ZhangHanDong/openwalkietalkie/docs/host-research/critic.md

# critic

COMPLETENESS CRITIQUE (checked 2026-09-18 on this Mac: macOS 27.0 build 26A428, deck paired as "Codex Micro" C2:2D:81:AB:88:81 with HFP/AVRCP/A2DP/HID/BLE). Input caveat: the task says five reports but only three reached me (openmicrokbd, agent-cli-hooks, desktop-apps — the last cut off mid-sentence at "ChatGPT desktop: OUT of v1 ... + c"). Nothing I received covers (a) the voice pipeline (STT/TTS engines, audio device routing, mixer, permissions) or (b) the open-API transport/protocol/auth design; if reports 4 and 5 exist they must be checked against the facts below.

A. CONTRADICTIONS / CONFLICTS BETWEEN REPORTS AND SPEC
1. API transport: openmicrokbd report recommends line-delimited JSON-RPC over a Unix socket (optionally WebSocket); agent-cli-hooks recommends Claude Code `type:"http"` hooks POSTing to "the daemon's localhost API". Claude HTTP hooks only support http(s) URLs with optional headers (cc_hooks.md:514-535) — so a loopback HTTP listener is mandatory regardless, and Codex/Gemini hooks are command/mcp_tool only (codex_hooks.md:193), so a hook-helper binary is ALSO mandatory. Resolution: two front doors (Unix socket for GUI/scripts/deck-mcp with peer-cred auth; loopback HTTP with a per-install bearer token for hooks and non-Rust clients), one internal event bus.
2. Non-exclusive HID open: openmicrokbd lists "can hidapi open the BLE collection while Codex desktop holds it" as open; it is already done in production (host/src/main.rs:144 `set_open_exclusive(false)`, host/README.md:84 "opens HID without seizing the device"). The exclusive-access note in openmicrokbd fw/README is USB-only. Resolved.
3. Spec "daemon does no summarization; roster titles are window titles verbatim" (spec.md:39) vs. CLI report (titles come from hooks: session_name/thread name/prompt, not window titles; window titles on macOS need Screen Recording/Accessibility TCC) vs. spec "Auto-announce one-liner 'Agent 3: tests passing, ready'" (spec.md:116) which requires summarizing. Design must pick a title source per agent kind and a summarization policy (heuristic first-sentence vs LLM call needing an API key). Unresolved decision.
4. Ready-card "suggested next steps the agent offered" (spec.md:52, agent-command-deck.md:90-93 sends the highlighted step as `answer`) has no source in any CLI (agent-cli-hooks §5). Either drop `type:r` choices in v1 or synthesize.
5. Card capacities vs sources: `card.text` ≤128 B, ≤4 choices ×32 B, single choice (deck-protocol.md:115) vs Claude AskUserQuestion 1-4 questions with `multiSelect` and free-length labels, Codex approvals with long command strings, Codex requestUserInput 1-3 questions with `isOther`. Truncation + multiSelect policy (PTT-only? first N?) is undefined anywhere.
6. Report-size wording: deck-protocol.md:11 "63-byte reports" vs openmicrokbd "64-byte reports" — consistent (64 incl. report id 6; host/README.md:89-90 "64 bytes… BLE transports the 63 bytes after report ID 6"). Not a bug, but the orchestrator should state hidapi buffers as 64 bytes with byte 0 = 6.
7. Terminal fallback matrix (tmux/iTerm2/Terminal.app) omits the only terminal installed here: Ghostty (/Applications/Ghostty.app; tmux absent). Filled below.

B. GAPS NOBODY COVERED — FILLED WITH SOURCED ANSWERS
8. Session/gating rules the daemon must implement (deck-protocol.md:70-104, agent-command-deck.md:83-96, 248-268): hello every 5 s with random 32-bit sid and `hm`; device `hello.sid != mine` → full sync (`agent`/`card`/`reply`/`ws`/`macro`/`usage`[/`faces`]) then `synced`; `boot:1` → push persisted `faces`+`set`, `boot:0` → adopt device `faces` and persist; 15 s without hello = host offline on device; on link drop release every synthesised key and cancel any PTT utterance; handle `up`; device sends nothing on ch5 before the first host line; `answer` only sent while host present and the daemon MUST `card clear` within 5 s or the deck shows "not delivered" and reverts — i.e. clear when the answer is DELIVERED to the agent (hook response returned / keystrokes sent / app-server response), not when the agent acts; `focus` must echo `channel.seq` as `ack`; `ptt ctx:name` must be answered with `name` (≤16 B — 5 CJK chars); `ptt ctx:codex` only stops TTS; `set` for speaker/mic/announce/chime is host-side and must be persisted (device persists nothing, agent-command-deck.md:277-282); pacing ≤1 report/8 ms, ≤~4 `agent` updates/s/agent, firmware queue of 64 shared by all channels (deck-protocol.md:39-43).
9. Consequence of #8 pacing: two independent HID writers (today's icon-sync LaunchAgent + a new deck daemon) cannot coordinate the 8 ms pace or the 64-entry queue → fold channel-3 icon sync into the daemon (one reader/writer per host), keep `flock` single-instance (host/src/main.rs:36-55).
10. Audio devices (verified with CoreAudio probe): the deck appears as TWO CoreAudio devices both named "Codex Micro": input uid `C2-2D-81-AB-88-81:input` 1ch 16 kHz (HFP) and output uid `C2-2D-81-AB-88-81:output` 2ch 44.1 kHz (A2DP), transport `blue`. Select by UID/BT address (name is ambiguous, and identical across units); never change the system default device. HFP mic use forces the SCO route and suspends A2DP (firmware handles BT_NOTIFY_A2DP_SUSPEND_IND, native/src/bluetooth.c:452; Apple support: "quit any apps that use your Bluetooth headphones' built-in microphone" to restore quality). So: open the mic only for the PTT hold; TTS/chimes played during/just after PTT go through 8/16 kHz SCO; route flips add latency; the "audio mixer with priority queue" (spec.md:117) must survive device sample-rate/route changes.
11. STT on this Mac (ran the researcher's speechcheck): SFSpeechRecognizer en-US available+on-device; zh-CN and en-GB available but on-device=false (server-based, audio leaves the Mac); auth status 0 (notDetermined); macOS 26+ SpeechTranscriber: 45 supported locales, installed = 9 English locales only. Chinese PTT therefore needs Apple server recognition or a bundled local model (whisper.cpp/sherpa-onnx). No STT language setting exists in the Settings face (agent-command-deck.md:143-154) → daemon config must carry locale(s).
12. TTS: `say -v '?'` lists 186 voices here (64 en_/zh_); a 16 kHz mono test file exists in the scratchpad (tts_test16k.wav, 2.7 s) showing `say -o` output was tried. Per-agent voice identity (spec.md:135) is feasible with AVSpeechSynthesizer/`say -v`; unresolved: engine choice, voice→agent assignment persistence, stripping code fences/markdown before speaking `last_assistant_message`.
13. TCC for a headless daemon: TCC attributes a launchd agent to its own executable; microphone (and speech-recognition) prompts need an embedded `__info_plist` with CFBundleIdentifier, CFBundleName, NSMicrophoneUsageDescription (naudio issue #105; Apple forums 111100). Cleanest: ship the daemon inside the .app bundle and register it with SMAppService (macOS 13+, plist in `Contents/Library/LaunchAgents/`, `BundleProgram` relative path, `SMAppService.agent(plistName:)` register/unregister/status; user sees it in Login Items) — this also answers openmicrokbd's "where does the daemon live / Sparkle restarts" question. AX/keystroke/Automation grants must be requested by the daemon, not by the MCP child (desktop-apps).
14. Focus/injection on the installed terminal: Ghostty ≥1.3 AppleScript exposes application/window/tab/terminal/surface configuration; window `id,name,selected tab`; tab `id,name,index,selected,focused terminal`; terminal `id,name,working directory`; commands `focus`, `activate window`, `select tab`, `input text`, `send key`, `new window/tab`, `split`, `perform action`; needs Automation TCC. No tty/pid property and no per-surface env var (only GHOSTTY_RESOURCES_DIR, TERM_PROGRAM=ghostty) → map hook session→terminal by `working directory` == hook `cwd` (ambiguous if several sessions share a cwd) or by title; Claude's `terminalSequence` hook output can stamp a deterministic title (session id) to match Ghostty `name`.
15. Two-way focus sync on macOS: NSWorkspace gives app activation only; tab-level focus needs polling Ghostty `selected tab`/`focused terminal` (Automation) or AX focused-window title (Accessibility). Spec's channel 1-4 ↔ Ctrl+Alt+Shift+1..4 binds and `ws`/`key` Omarchy semantics have no macOS equivalent (no public Spaces API; window names need Screen Recording) → v1 macOS: Omarchy face pushes nothing or a degraded app list; decide.
16. Usage face sources: Claude Code statusLine JSON `rate_limits.five_hour/seven_day{used_percentage,resets_at}` (+`spend_limit`; Pro/Max only, only after first API response; cc_statusline.md:193-195, 293-300, 339); Codex app-server `account/rateLimits/read` → `{rateLimits{primary{usedPercent,windowDurationMins,resetsAt},secondary}, rateLimitsByLimitId, rateLimitResetCredits}` plus `account/rateLimits/updated` notification and `account/usage/read` (codex_appserver.txt:1424-1428, 1601-1625; requires an app-server connection); Gemini CLI: `/stats model` shows session usage and limits interactively, no programmatic daily-quota API; geminicli.com quota page states "Gemini CLI was replaced by Antigravity CLI on June 18th, 2026" for unpaid/Google One users. `refresh {what:usage}` from the deck → daemon re-queries.
17. Agent liveness: no SessionEnd fires on SIGKILL/closed terminal; capture the agent pid at SessionStart (`$PPID` of the hook shell → CLI process) and poll `kill(pid,0)`; Claude also offers `claude agents --json` (CLI report).
18. Third-party clients ("scripts, other tools"): the API needs a generic virtual-agent surface (register agent → slot id, push state/card/reply, receive answer/ptt/snooze) with a lease/heartbeat so a dead client's agents go `gone`, a slot policy for >8 sessions (device ids 1..8; LRU-evict Idle), and per-client scopes (hook payloads carry prompts/tool inputs; broadcasting them to every client is a privacy leak). Loopback HTTP must also defend against browser CSRF (token + Host/Origin check).
19. Linux/Omarchy (the spec's first-party target, spec.md:10,129-133) is untouched by all reports: Hyprland IPC socket `$XDG_RUNTIME_DIR/hypr/[HIS]/.socket.sock` (requests) and `.socket2.sock` (events), `hyprctl clients -j`/`activewindow -j`, `dispatch focuswindow address:0x…`; hidraw permissions (udev), BlueZ/PipeWire HFP (mSBC) — all unverified beyond the socket-1 path.

C. STILL UNKNOWN — see open_questions (SCO bring-up latency and lost first syllables, whether hidapi input reports are duplicated to every non-seizing client, HTTP-hook hold-open behaviour, summarization policy, multiSelect mapping, Codex acceptForSession via hooks, voice-command grammar for "report", Gemini future).

## Facts
- [verified] Only three researcher reports (openmicrokbd, agent-cli-hooks, desktop-apps) were delivered to this critic; the desktop-apps text is truncated mid-sentence and no report on the voice pipeline or on the open-API transport/auth design was received.
  - source: Task input as received by this subagent (2026-09-18)
- [verified] Claude Code HTTP hooks POST JSON to an http(s) `url` with optional `headers` whose `$VAR` values are interpolated only for variables listed in `httpHookAllowedEnvVars`; `allowedHttpHookUrls` restricts which URLs may run. Example in docs: `http://localhost:8080/hooks/pre-tool-use` with `Authorization: Bearer $MY_TOKEN`. There is no Unix-socket hook transport.
  - source: scratchpad/cc_hooks.md:282-283, 514, 531-535 (https://code.claude.com/docs/en/hooks, fetched 2026-09-18)
- [verified] Codex hooks support only `command` (with optional `async: true`) and `mcp_tool` handler types; `prompt`/`agent`/http are not supported, so Codex (and Gemini) integration needs a hook-helper executable on a stable path.
  - source: scratchpad/codex_hooks.md:191-193, 249-265, 564-600 (https://learn.chatgpt.com/docs/hooks)
- [verified] The existing host opens the BLE HID vendor collection non-exclusively (`api.set_open_exclusive(false)`) and coexists with the Codex desktop app on the same device; README states it 'opens HID without seizing the device' and that the full report is 64 bytes `[6, 3, len, payload…]` with BLE carrying the 63 bytes after report id 6.
  - source: /Users/tony/projects/conol/openmicrodial/host/src/main.rs:142-144; host/README.md:81-90
- [verified] Deck session rules a daemon must implement: hello every 5 s with a random 32-bit sid; device reply `sid` != mine → full sync then `synced`; `boot:1` → push persisted faces/set, `boot:0` → adopt device faces; 15 s without hello → device shows host offline; on link drop release synthesised keys and cancel PTT; `up` means everything released; device sends nothing on channel 5 before the first host line; host lines never echo as mirror events.
  - source: /Users/tony/projects/conol/openmicrodial/docs/deck-protocol.md:70-104
- [verified] `answer` is only sent while a host is present and the card shows 'sent' until the host sends `card clear`; with no clear within 5 s the card reverts and a 'not delivered' toast appears — so the daemon must acknowledge delivery within 5 s, independent of when the agent acts on it.
  - source: /Users/tony/projects/conol/openmicrodial/docs/deck-protocol.md:135; docs/agent-command-deck.md:83-85
- [verified] Pacing: at most one output report per 8 ms; the native firmware queues 64 messages shared by reports, input and diagnostics and drops the link on overflow; at most ~4 `agent` updates/s per agent; device per-edge events are ≥4 ms apart.
  - source: /Users/tony/projects/conol/openmicrodial/docs/deck-protocol.md:37-49
- [verified] The device persists nothing: strip (`faces`) and settings reset on every boot; speaker, mic gain, auto-announce and chime are host-side values the host must store and apply; brightness/idlehome/autojump/demo are device-side.
  - source: /Users/tony/projects/conol/openmicrodial/docs/agent-command-deck.md:143-158, 277-282
- [verified] `ptt ctx:name` requires the host to answer with `name {text ≤16 bytes}` while the naming overlay is open; `ptt ctx:codex` is used by the host only to stop speaking; `focus` must echo the device `channel.seq` as `ack` or it is applied unconditionally when `ack` is absent; `transcript` carries ≤200 B tail (send the last ~120 B) with `final:1` on the last one.
  - source: /Users/tony/projects/conol/openmicrodial/docs/deck-protocol.md:117-118, 123, 133-134; docs/agent-command-deck.md:175-178, 226-228
- [verified] The deck is paired with this Mac as 'Codex Micro' (address C2:2D:81:AB:88:81, VID 0x303A PID 0x8360, minor type Headset) with services HFP, AVRCP, A2DP, HID, BLE.
  - source: `system_profiler SPBluetoothDataType` run 2026-09-18 on this Mac
- [verified] CoreAudio exposes the deck as two devices both named 'Codex Micro': input uid `C2-2D-81-AB-88-81:input` (1 ch, 16000 Hz, transport blue) and output uid `C2-2D-81-AB-88-81:output` (2 ch, 44100 Hz). Device selection must use the UID/BT address, not the name.
  - source: scratchpad/list_audio (CoreAudio kAudioHardwarePropertyDevices probe compiled from list_audio.c) run 2026-09-18
- [verified] The firmware advertises HFP (0x111e), Audio Sink (0x110b), A/V Remote Control (0x110c/0x110e) and Generic Audio (0x1203) in its Classic EIR under the name 'Codex Micro', logs SCO codec/air-mode on connect (16 kHz for mSBC, 8 kHz CVSD, 32 kHz for codec id 3) and receives A2DP suspend/start indications.
  - source: /Users/tony/projects/conol/openmicrodial/native/src/bluetooth.c:17, 400-413, 425-437, 447-452
- [likely] On macOS, using a Bluetooth headset's microphone switches the device to the HFP/SCO route and degrades output quality; Apple's own guidance is to quit apps using the headset microphone to restore A2DP quality. Consequently TTS/chimes while the mic stream is open are 8/16 kHz mono and route switches add latency.
  - source: Web search 2026-09-18: https://discussions.apple.com/thread/256182176 ; https://support.coscreen.co/hc/en-us/articles/1500002060342 ; https://gist.github.com/dvf/3771e58085568559c429d05ccc339219 (secondary sources quoting Apple support text)
- [verified] On this Mac SFSpeechRecognizer reports en-US available with on-device recognition; zh-CN and en-GB available but on-device=false (server-based); authorization status notDetermined; macOS 26 SpeechTranscriber supports 45 locales with only 9 English locales installed (en_AU, en_GB, en_CA, en_SG, en_IE, en_IN, en_ZA, en_NZ, en_US).
  - source: scratchpad/speechcheck (Swift probe, source speechcheck.swift) run 2026-09-18
- [verified] `say -v '?'` lists 186 voices on this Mac, 64 of them en_* or zh_*; a 16 kHz mono 2.7 s TTS test file (tts_test16k.wav) exists in the scratchpad from prior experimentation.
  - source: `say -v '?' | wc -l`; `afinfo scratchpad/tts_test16k.wav` (2026-09-18)
- [likely] TCC attributes a launchd agent to its own executable; for microphone access a bare daemon needs an embedded `__info_plist` (CFBundleIdentifier, CFBundleName, NSMicrophoneUsageDescription) or the prompt/attribution misbehaves (naudio issue: denied permission captured silence with no diagnostic and the Privacy pane listed the raw binary name).
  - source: https://github.com/KJ5HST-LABS/naudio/issues/105 ; https://developer.apple.com/forums/thread/111100 ; https://developer.apple.com/documentation/bundleresources/information-property-list/nsmicrophoneusagedescription (search 2026-09-18)
- [likely] SMAppService (macOS 13+) registers a LaunchAgent whose plist lives in `<App>.app/Contents/Library/LaunchAgents/` with a `BundleProgram` path relative to the bundle, via `SMAppService.agent(plistName:)` `.register()/.unregister()/.status`; the whole bundle is code-signed together and the agent appears under System Settings Login Items.
  - source: https://developer.apple.com/forums/thread/745009?page=2 ; https://gist.github.com/Matejkob/f8b1f6a7606f30777552372bab36c338 ; https://theevilbit.github.io/posts/smappservice/ (Apple's own page returned no body to the fetcher)
- [verified] Ghostty is the only terminal emulator installed on this Mac (/Applications/Ghostty.app); tmux is not installed.
  - source: `ls /Applications | grep -i 'iterm\|ghostty\|warp\|kitty\|wezterm\|alacritty'`; `which tmux` (2026-09-18)
- [verified] Ghostty AppleScript (since Ghostty 1.3.0, Automation TCC) exposes classes application/window/tab/terminal/surface configuration with window `id,name,selected tab`, tab `id,name,index,selected,focused terminal`, terminal `id,name,working directory`, and commands `focus`, `activate window`, `select tab`, `input text`, `send key`, `send mouse *`, `new window/tab`, `split`, `perform action`, `close*`. No tty or pid property.
  - source: https://ghostty.org/docs/features/applescript (fetched 2026-09-18)
- [likely] Ghostty sets GHOSTTY_RESOURCES_DIR and TERM_PROGRAM=ghostty (TERM=xterm-ghostty) in child shells; there is no documented per-surface identifier env var, so a hook cannot learn its Ghostty surface id from the environment.
  - source: https://ghostty.org/docs/features/shell-integration ; https://ghostty.org/docs/config/reference (search 2026-09-18)
- [verified] Claude Code statusLine JSON includes `rate_limits.five_hour/seven_day/spend_limit{used_percentage, resets_at}`; present only for claude.ai Pro/Max (or apps-gateway spend limits), only after the first API response, each window independently absent.
  - source: scratchpad/cc_statusline.md:193-195, 293-305, 339 (https://code.claude.com/docs/en/statusline)
- [verified] Codex app-server exposes `account/rateLimits/read` → `{rateLimits{limitId, primary{usedPercent, windowDurationMins, resetsAt}, secondary, rateLimitReachedType}, rateLimitsByLimitId, rateLimitResetCredits}`, a server notification `account/rateLimits/updated`, and `account/usage/read` for token-activity summaries.
  - source: scratchpad/codex_appserver.txt:1409-1428, 1601-1625 (https://learn.chatgpt.com/docs/app-server)
- [verified] Gemini CLI shows session token usage and quota limits only interactively via `/stats model`; its quota page lists per-auth daily request limits (Google Account 1,000/1,500/2,000; API key free 250) and states 'Gemini CLI was replaced by Antigravity CLI on June 18th, 2026' for unpaid tier and Google One users; no programmatic remaining-quota API is documented.
  - source: https://geminicli.com/docs/resources/quota-and-pricing/ (fetched 2026-09-18); https://github.com/google-gemini/gemini-cli/discussions/3096
- [verified] The deck wire vocabulary `AgentKind` is exactly Claude/Codex/Gemini/Other and the Usage face takes ≤6 items {n(20), p 0..100, r(24), c?} with a `period` (12) string; `refresh {what:'usage'}` asks the host for a fresh `usage`.
  - source: /Users/tony/projects/conol/openmicrodial/src/deck/msg.rs:11-16; docs/deck-protocol.md:121, 139
- [verified] tools/deck-sim.py opens the device with python-hidapi `hid.device().open(vid,pid)`, sets non-blocking reads of 64 bytes, and sleeps `--pace` ms after every written report; it is the only reference host and no deck daemon exists yet.
  - source: /Users/tony/projects/conol/openmicrodial/tools/deck-sim.py:118-150; docs/agent-command-deck.md:275-276
- [likely] The spec's first-party integration target is Omarchy Linux/Hyprland (roster from hyprctl window titles, daemon shipped as an Omarchy module); none of the received reports covers the Linux side. Hyprland's request socket is `$XDG_RUNTIME_DIR/hypr/[HIS]/.socket.sock` with a second socket for event streaming; `hyprctl clients -j` / `activewindow -j` and `dispatch focuswindow address:…` are the relevant commands and `.socket2.sock` emits activewindow/windowtitle/openwindow/closewindow/workspace events.
  - source: scratchpad/spec.md:10, 29, 129-133; https://wiki.hypr.land/IPC/ (fetched 2026-09-18; only the socket-1 path was legible in the fetch, the rest is from prior knowledge)
- [verified] The spec demands features that no CLI exposes: 'suggested next steps' on Ready cards, a 'report' voice check-in producing a TTS status summary, and auto-announce one-liners — all require host-side summarization or an intent grammar, contradicting spec.md:39 'the daemon does no summarization'.
  - source: scratchpad/spec.md:39, 52, 112, 116; agent-cli-hooks report §5 ('suggested next steps have NO source in any CLI')
- [verified] The deck's `card` supports one selected choice among ≤4 strings of ≤32 bytes and text ≤128 bytes, whereas Claude AskUserQuestion allows `multiSelect` and 1-4 questions per call and Codex requestUserInput allows `isOther` free-form; no report defines the truncation/multiSelect mapping.
  - source: /Users/tony/projects/conol/openmicrodial/docs/deck-protocol.md:115; agent-cli-hooks facts on AskUserQuestion and item/tool/requestUserInput
- [verified] The machine reports macOS ProductVersion 27.0 BuildVersion 26A428, matching the desktop-apps report's environment line.
  - source: `sw_vers` (2026-09-18)

## Options
### Two front doors for the open API: Unix socket (JSON-RPC, peer-cred auth) + loopback HTTP (bearer token) over one internal event bus
- pros: Satisfies Claude HTTP hooks (mandatory http URL), Codex/Gemini command hooks via a tiny helper, gpui GUI and scripts over the socket, deck-mcp stdio child over the socket; token in the hook URL/header lives in the user's 0600 settings files; Origin/Host checks block browser CSRF.
- cons: Two listeners to secure and version; the hook helper binary still needs a stable non-translocated path (openmicrokbd refuses AppTranslocation).
- recommendation: Adopt; resolves the transport contradiction between the openmicrokbd and agent-cli-hooks reports.
### Fold icon sync (channel 3) into the deck daemon; one HID reader/writer per host
- pros: Only one process can honour the 8 ms pace and the shared 64-entry firmware queue; removes the second LaunchAgent and lock file.
- cons: Daemon must carry the Codex config.toml watcher and OMD2 codec from host/src; migration/uninstall of the existing com.conol.openmicrodial.icon-sync agent needed.
- recommendation: Adopt.
### Daemon as a signed helper inside the .app bundle registered with SMAppService, carrying an Info.plist with microphone/speech-recognition usage strings
- pros: Stable TCC identity for mic, speech, Accessibility and Automation grants; survives Sparkle updates; user-visible in Login Items; answers the openmicrokbd open question on daemon placement.
- cons: macOS 13+ only; the LaunchAgent cannot own a tray icon (GUI process still needed for that); first-run permission prompts must be driven by the GUI calling the daemon.
- recommendation: Adopt for macOS; keep tools/install-host.sh only as a dev fallback.
### Audio policy: open the deck mic (HFP) only during the PTT hold; play chimes/TTS to the A2DP output selected by UID; software gain implements the Speaker/Mic settings
- pros: Restores A2DP quality between utterances, no system-volume side effects, deterministic mixer priorities (question > ready > chatter, PTT preempts).
- cons: SCO bring-up latency may clip the first syllables (unmeasured); TTS played within ~1 s after PTT release goes through SCO; A2DP start latency may clip the first chime.
- recommendation: Adopt provisionally; measure SCO/A2DP switch latency on hardware before freezing (open question).
### STT engine: Apple Speech (SFSpeechRecognizer/SpeechTranscriber) for English on-device, with an opt-in server mode for zh-CN, or a bundled local model (whisper.cpp / sherpa-onnx) for offline Chinese
- pros: Zero-dependency English on this Mac; Chinese works today via Apple's server recognizer.
- cons: zh-CN audio leaves the machine with Apple Speech; local models add binary size/CPU; the Settings face has no language row so locale must live in daemon config/GUI.
- recommendation: Decide after the (missing) voice report is reconciled with the verified availability facts.

## Open questions
- Reports 4 and 5 (voice pipeline; API/transport design) were not delivered to this critic — verify they exist and reconcile them with the audio/STT/TTS/TCC facts above.
- SCO bring-up latency on macOS with this deck: how many ms from opening the HFP input device to first usable samples, and are the first syllables of a PTT utterance lost? Alternative of keeping the mic stream open (permanent SCO) costs battery and TTS quality — needs hardware measurement.
- Does macOS IOKit HID deliver every input report to every non-seizing client (Codex desktop + daemon) on a BLE HID device, and does the daemon's read loop ever starve Codex desktop's channel-2 replies? (Works empirically for icon sync; not proven under load.)
- While a synchronous Claude PermissionRequest/PreToolUse HTTP hook is held open waiting for the deck (the 5 s `card clear` budget vs human response time), is the terminal dialog suppressed, and what hold timeout/fall-through should the daemon use so both the terminal and the deck can answer?
- Title source per agent kind for the 64-byte roster one-liner on macOS (hook-derived session_name/thread name/prompt vs window title needing Screen Recording/Accessibility) — the spec's 'verbatim window title, no summarization' cannot be met via hooks.
- Summarization policy for auto-announce one-liners, the 'report' check-in and Ready-card next steps: heuristic (first sentence, strip code fences) or an LLM call (which provider/key, cost, privacy)?
- Mapping of Claude `multiSelect` AskUserQuestion, >4 options, and Codex `isOther` free-form questions onto the single-choice ≤4×32 B card; truncation rules for long approval commands in ≤128 B text.
- Voice-command grammar: how does the daemon distinguish a dictated order from commands like 'report', 'approve', 'switch to 3' in a PTT transcript, and in which languages?
- Codex 'Allow always/for session' from the deck: PermissionRequest hooks only allow/deny; acceptForSession exists only on the app-server path — should the card offer it only when the session is app-server-attached?
- What does the macOS daemon do with the Omarchy face (`ws`, `key`, workspace binds 1-4) — hide the face, push a degraded app list, or map SCROLL/LEFT/RIGHT to Mission Control keystrokes (CGEvent needs Accessibility)?
- Two-way focus sync on macOS: poll Ghostty `selected tab`/`focused terminal` via AppleScript (Automation TCC, ~500 ms) or observe AX focused-window titles (Accessibility)? Mapping a hook session to a Ghostty terminal when several sessions share a working directory (use `terminalSequence` title stamping?).
- Audio fallback policy when only the BLE HID link is up and Classic audio is not connected: play chimes/TTS on the Mac's default output, or stay silent and show it in Settings › Host?
- Slot policy: >8 live sessions vs `agent.id` 1..8, persistence of slot↔session mapping across daemon restarts, and eviction order.
- API scopes/privacy: which clients may read hook payloads (prompts, tool inputs) and which may answer cards or inject text; is remote (non-loopback) access in scope for the open API?
- Gemini CLI viability: given the June 18 2026 replacement by Antigravity CLI for unpaid/Google One users, does the design still target Gemini CLI hooks or Antigravity?
- Linux/Omarchy port: hidraw/udev permissions for VID 303A PID 8360, BlueZ+PipeWire HFP (mSBC) capture, hyprctl event socket parsing — none researched; needed for the DHH/Omarchy deliverable in the spec.
- Log rotation and crash diagnostics for the LaunchAgent (current install-host.sh appends to one unbounded log file); where do daemon and GUI logs go and how does the GUI surface them?
