ZhangHanDong/openwalkietalkie/docs/section-12-coverage.md

# §12 failure-mode coverage audit (week 8)

Scope: every v1 row of `docs/host-service.md` §12, lines 1181–1215 — **35 rows**. No row is
marked v1.1/v2 in its entirety; row 1197 is split and only its v1 half (banner + `lsof` listener
+ change port → `integrations.repair`) is audited here.

Method: located candidate tests across `host/crates/*/tests/`, every `#[cfg(test)]` module under
`host/crates/*/src/**` (993 `#[test]`/`#[tokio::test]` functions) and `tools/host-test.sh`; read
every cited body; then mutated production code for 18 clauses and recorded red/green. Every
mutation was reverted; `git status` is clean.

Read-only pass. Nothing in the repo was changed.

---

## Row-by-row

| # | Row (§12) | Verdict | Test(s) | Missing piece |
|---|---|---|---|---|
| 1181 | Daemon crash | **partial** | KeepAlive: `tools/host-test.sh:248` (packaging step) + `tools/assert-bundle-identity.sh:106`. New sid → resync: `host/crates/deckd/src/hid.rs:1229` `a_link_up_hellos_a_zero_sid_writes_the_barrier_and_synced_goes_live`, `host/crates/deckd/src/device/session.rs:206` `a_foreign_or_zero_sid_starts_a_sync_and_synced_returns_to_live`, `tools/host-test.sh:1487` (`--hardware` restart row). Orphan grace 300 s: `host/crates/deck-model/src/roster.rs:1164` `a_lease_expires_into_the_orphan_grace_and_then_removal`. Reseed: `host/crates/deckd/src/liveness.rs:739` `the_roster_corrects_state_and_name_and_leaves_everything_else_alone`, `:778` `seeding_is_opt_in_and_only_for_unknown_interactive_sessions` | No test kills a daemon and inspects recovery. "restart ≤10 s" unmeasured; "device shows `offline` only if the gap exceeds 15 s" has no test at all; "held hooks end with the HTTP connection" is only tested for an orderly `Shutdown` (`deck-model/src/store.rs:1698`), never for a crash |
| 1182 | Held hook's client goes away → `HoldGone` | **covered** (proved) | `host/crates/deckd/tests/hooks_door.rs:74` `a_hook_client_that_goes_away_releases_its_hold_at_once`; `host/crates/deckd/tests/holds_guard.rs:34` `hold_guard_drop_sends_hold_gone`; `host/crates/deckd/tests/adapters_claude.rs:548` `a_released_hold_degrades_to_focus_terminal_under_the_same_id`; `host/crates/deck-model/src/cards.rs:1723` `a_hold_is_written_then_cleared_and_hold_gone_degrades_at_once`; `host/crates/deckd/src/core/handle.rs:616` `a_dropped_reply_is_an_internal_error_and_the_hold_guard_reports_on_drop`; Retry refusal: `host/crates/deck-model/src/cards.rs:2155` `a_failed_hold_card_refuses_retry_and_a_timeout_card_can_be_released` | — (`hooks_door.rs:74` asserts `hold_s >= 60` up front so the pass cannot come from expiry: the best-designed test in the table) |
| 1183 | Core → hid channel overflow | **partial** (behaviour proved) | `host/crates/deckd/src/core/mod.rs:3309` `an_overflow_replays_the_removals_it_refused_before_re_projecting` (drives a real `hid::Link`, asserts replay order, the wire barrier and `status.overflows == 1`); `:3214` `delivery_effects_resolve_and_the_overflow_reprojects_the_store`; `host/crates/deck-model/src/store.rs:1307` `overflow_reprojects_and_asks_for_a_barrier` | (a) "when the channel **drains below half**" is not pinned — mutating the gate to `<= OPS_CAPACITY` leaves all 436 deckd lib tests green (see M2). (b) The row names `metrics.get.outbox_overflows`; **no such field exists** — `metrics.get` publishes `overflows` (`core/dispatch.rs:231`), and the only `metrics.get` assertion is the zero case (`core/dispatch.rs:1383`) |
| 1184 | Hid → core: slow core | **uncovered** | Only an incidental proxy: `host/crates/deckd/src/core/mod.rs:3048` `metrics_get_waits_for_a_fresh_report` happens to show a device line handled while the call is parked | Nothing asserts `run_core`'s `try_recv` drain runs **before** the `select!` (`core/mod.rs:2408`), nothing asserts the hid→core channel is unbounded/never blocks, and the "≥4 ms apart" wire limit has no test (the only 4 ms in the tree is the host→device pacer's input, which is clamped to an 8 ms floor) |
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
