ZhangHanDong/openwalkietalkie/docs/releases/0.10.0.zh-CN.md

# OpenWalkieTalkie 0.10.0 升级说明

0.10.0 在 deck 上新增电脑资源页面 **System**，显示 Mac 的 CPU、内存、GPU 和磁盘剩余空间。同时改善 Flappy Bird 的局部刷新，并延长三款游戏的合成背景音乐。

## 电脑资源页面

- **CPU**：所有核心合计后的归一化使用率，范围 0–100%。
- **Memory**：已用／总内存，包括应用、不可换出（wired）和压缩内存。
- **GPU**：读取显卡驱动提供的利用率；多 GPU 时显示最忙的一颗。
- **Storage**：启动磁盘可写数据卷的可用／总空间。百分比表示**剩余空间**，空间较少时会改变提示颜色。

Mac 服务每 **2 秒**采样，只重绘显示值发生变化的表条。不可用的指标显示 **Not available**；超过 10 秒没有新数据时显示 **STALE**，主机断开后显示 **OFFLINE**。CPU 百分比需要两次采样后才会出现。

该页面仅在 **deck** 上提供，与订阅额度的 Usage 页面分开。新默认布局中，System 位于 Usage 后方。已有布局保持原样，请在 deck 上**双击 Shift → + → System → Enter** 添加。

需要同时更新 Mac 应用／deckd 服务和设备固件。旧服务不会发送电脑资源数据，新服务也不会向不支持此功能的旧固件发送这些消息。
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
