ZhangHanDong/openwalkietalkie/docs/mockups/1-face-strip.png

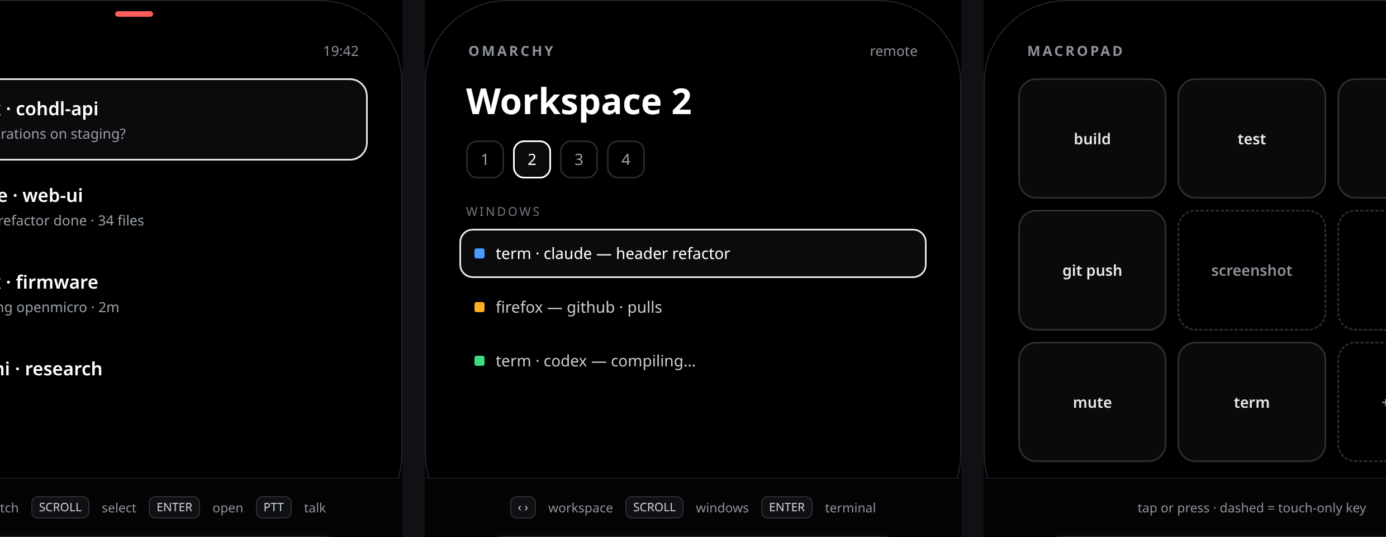
docs/mockups/1-face-strip.png
