ZhangHanDong/openwalkietalkie/docs/mockups/2-face-manager.png

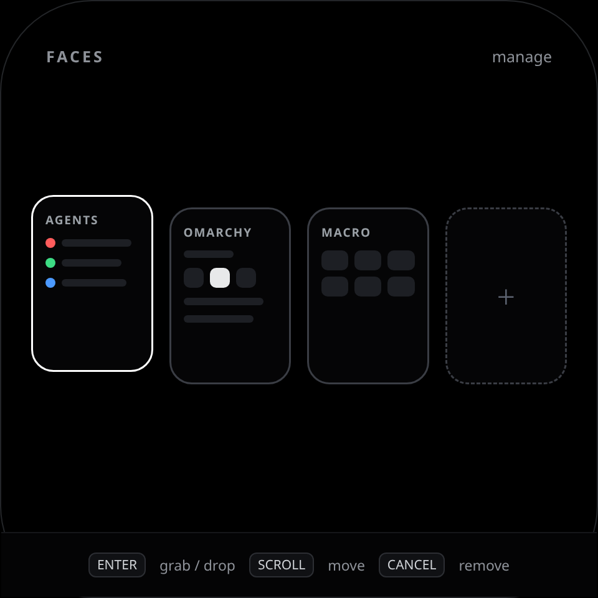
docs/mockups/2-face-manager.png
