ZhangHanDong/openwalkietalkie/docs/mockups/3-omarchy-remote.png

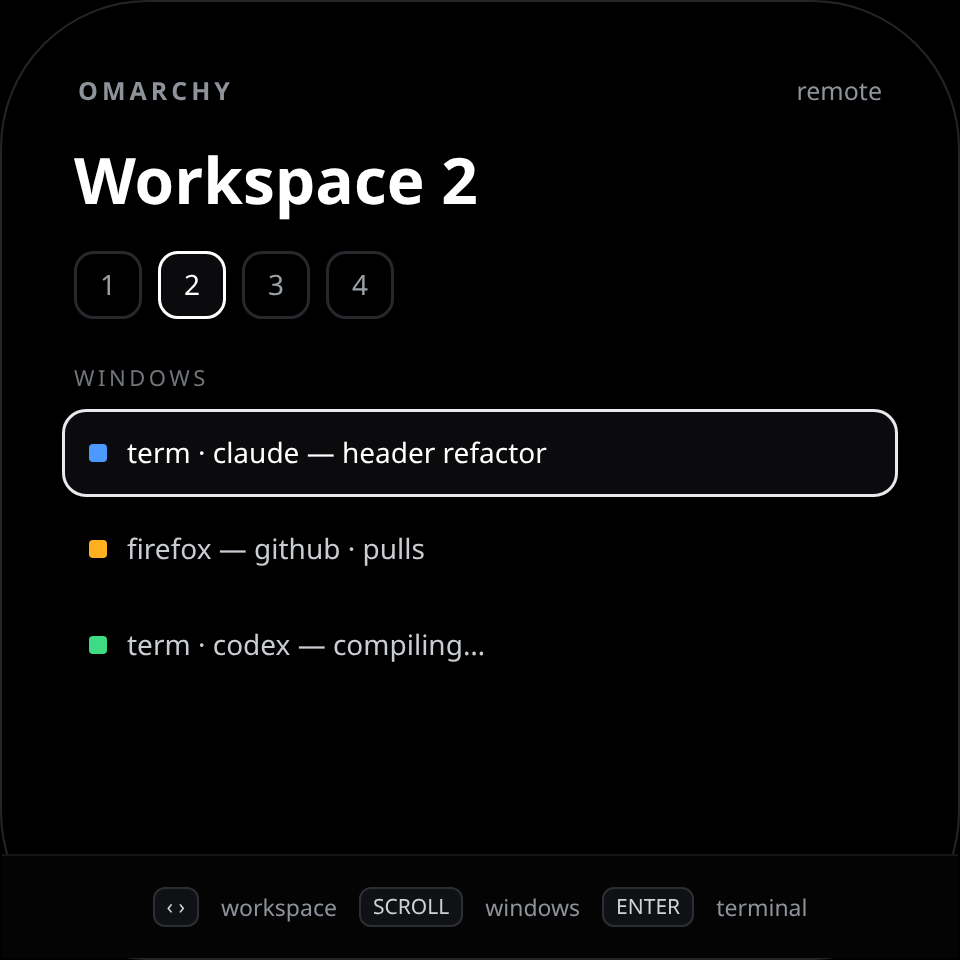
docs/mockups/3-omarchy-remote.png
