ZhangHanDong/openwalkietalkie/docs/mockups/4-macropad.png

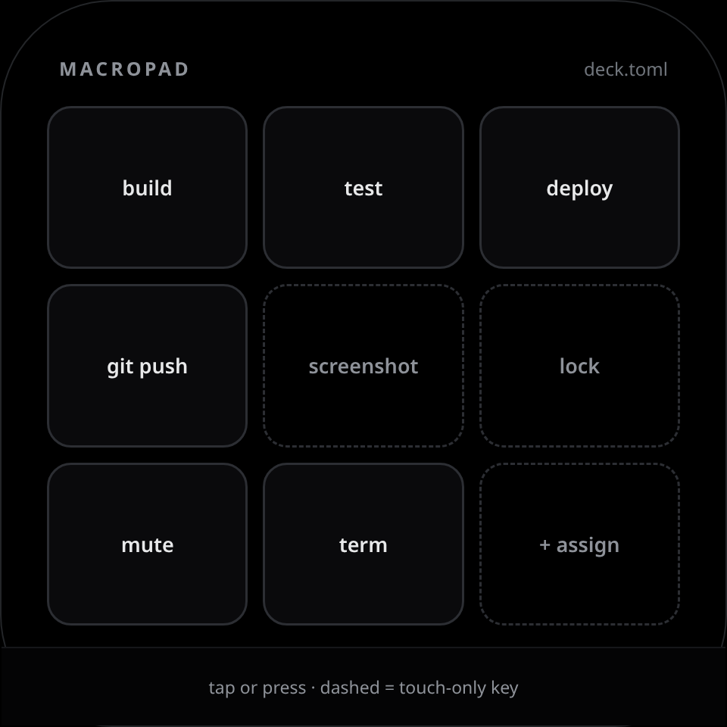
docs/mockups/4-macropad.png
