ZhangHanDong/openwalkietalkie/docs/mockups/6-roster.png

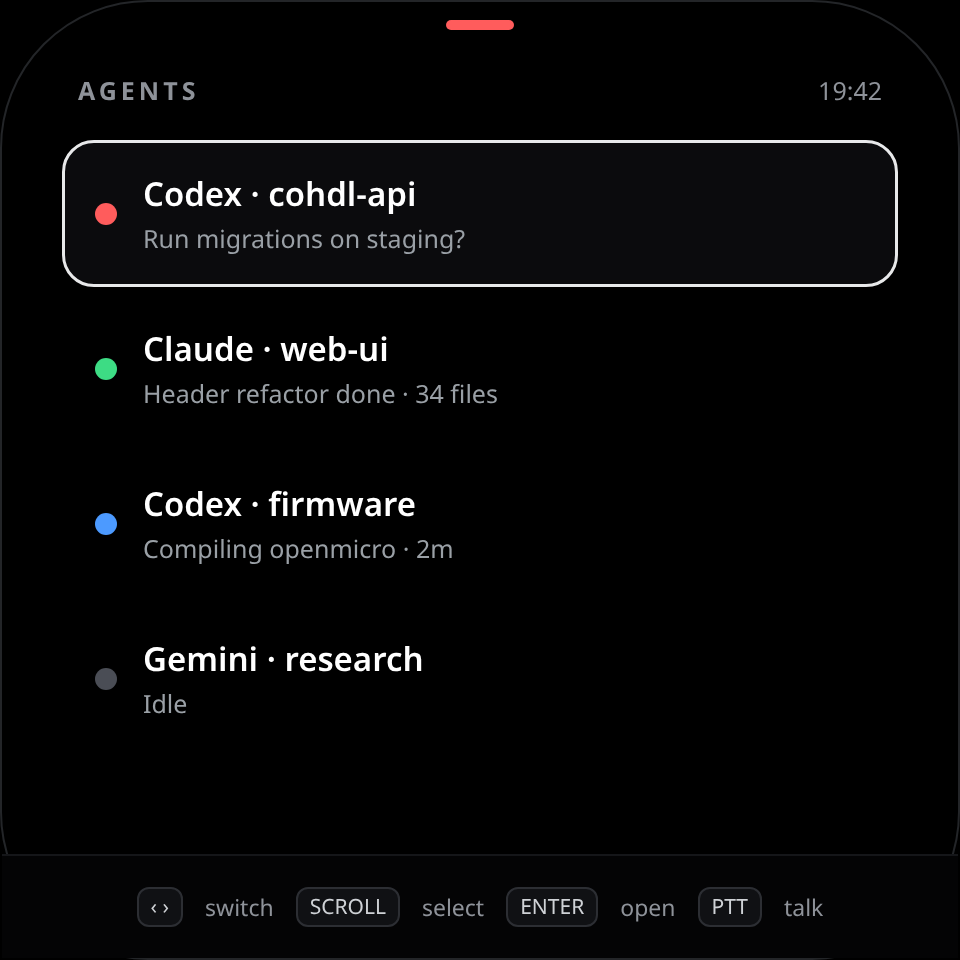
docs/mockups/6-roster.png
