ZhangHanDong/openwalkietalkie/docs/mockups/7-channel-ptt.png

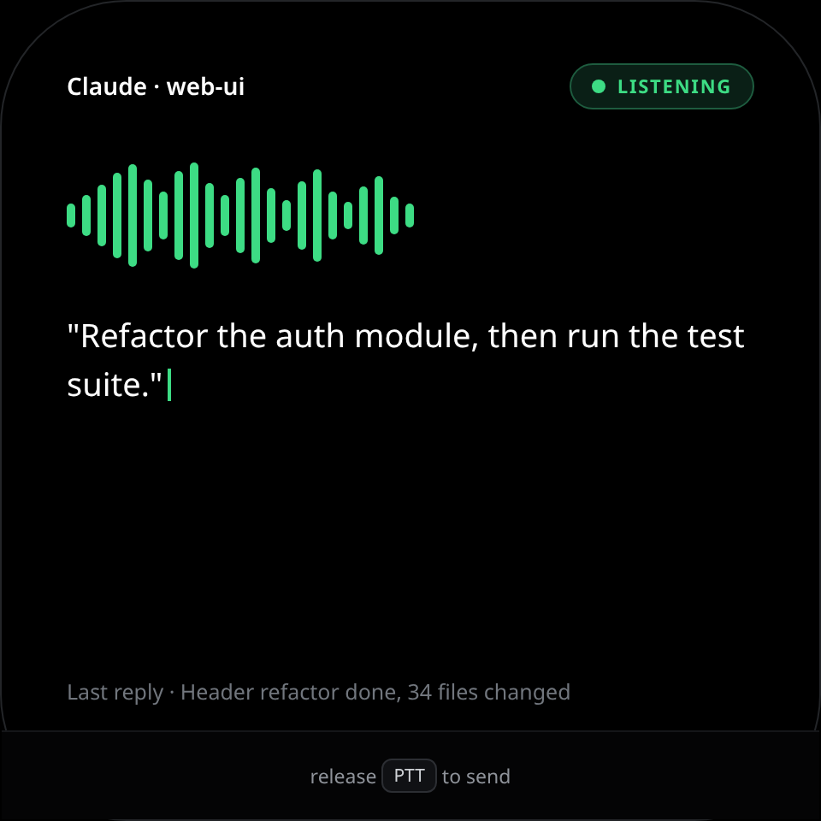
docs/mockups/7-channel-ptt.png
