ZhangHanDong/openwalkietalkie/docs/mockups/8-question-card.png

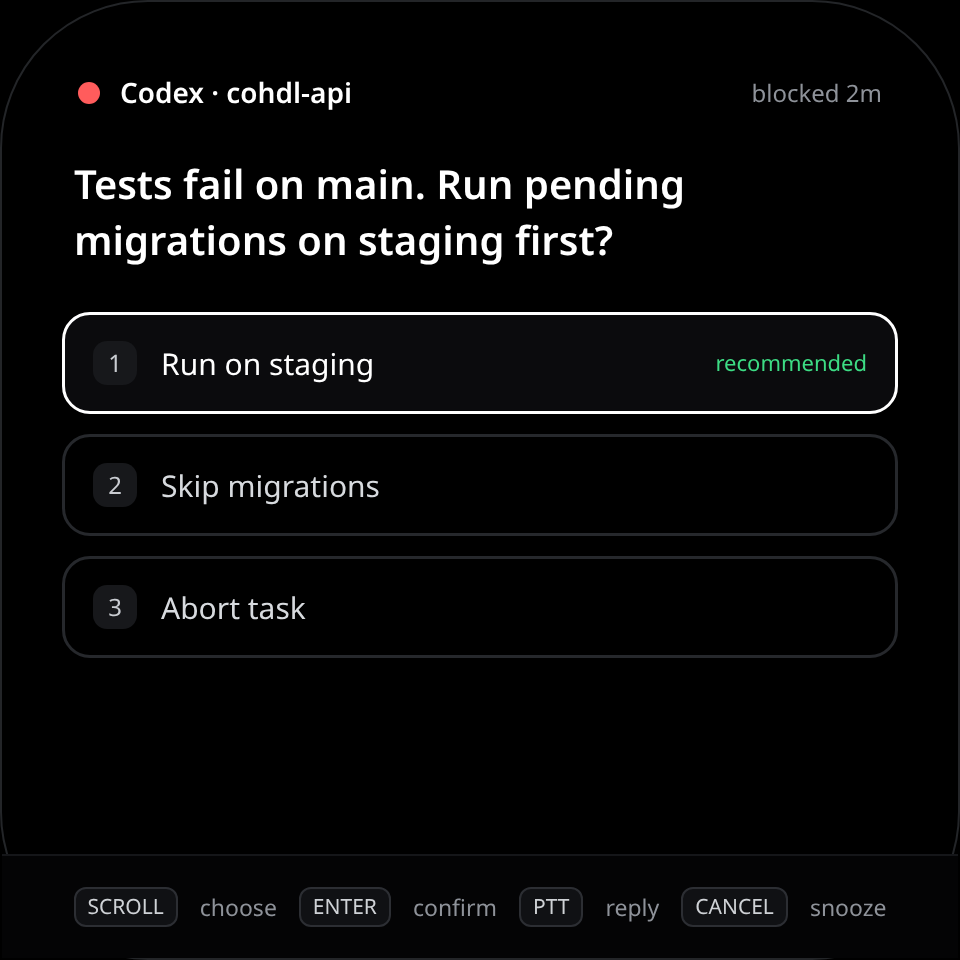
docs/mockups/8-question-card.png
