ZhangHanDong/openwalkietalkie/hardware/rev-b/jig/fab-jlcpcb/revb-flash-jig-bom-jlcpcb.csv

Comment | Designator | Footprint | LCSC Part # | Quantity | Design MPN | Design Manufacturer
UART | J1 | PinHeader_1x03_P2.54mm_Vertical | C49257 | 1 | 2.54-1*3PPin | BOOMELE
YZ105312061P-01 | P1,P2,P3 | Pogo_Xinyangze_YZ105312061P-01 | C5157237 | 3 | YZ105312061P-01 | Xinyangze
