ZhangHanDong/openwalkietalkie/hardware/rev-b/3d/bodyv6.13-revb-fit-assembly.step

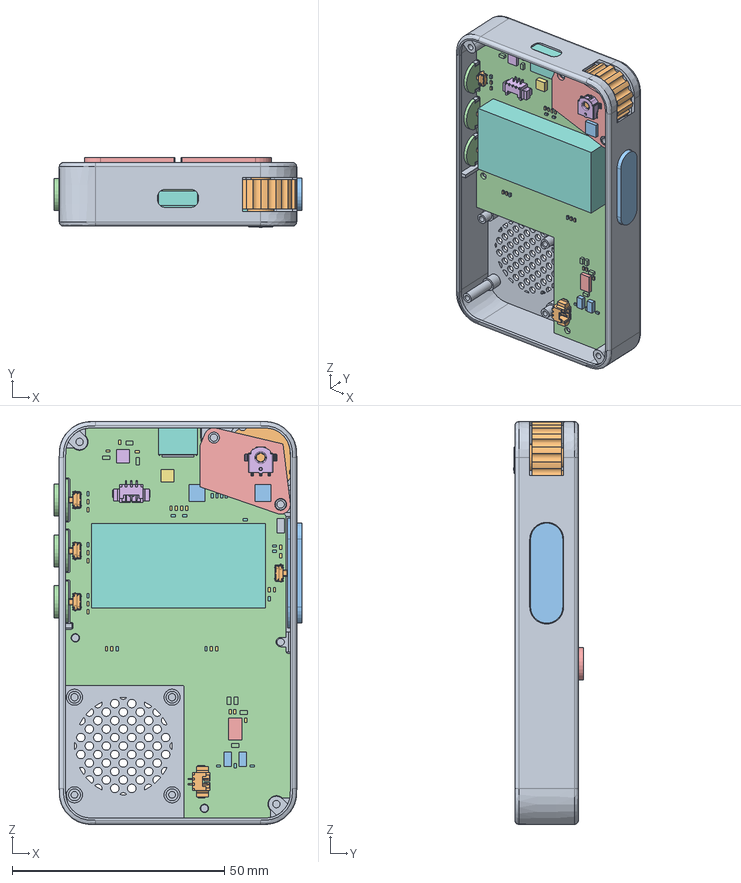
[picture p11: CAD file, 2026-10-13]
hardware/rev-b/3d/bodyv6.13-revb-fit-assembly.step
58.4 x 16.5 x 95.0 mm
