ZhangHanDong/openwalkietalkie/hardware/rev-b/3d/main-revb-populated-bodyv6.13.step

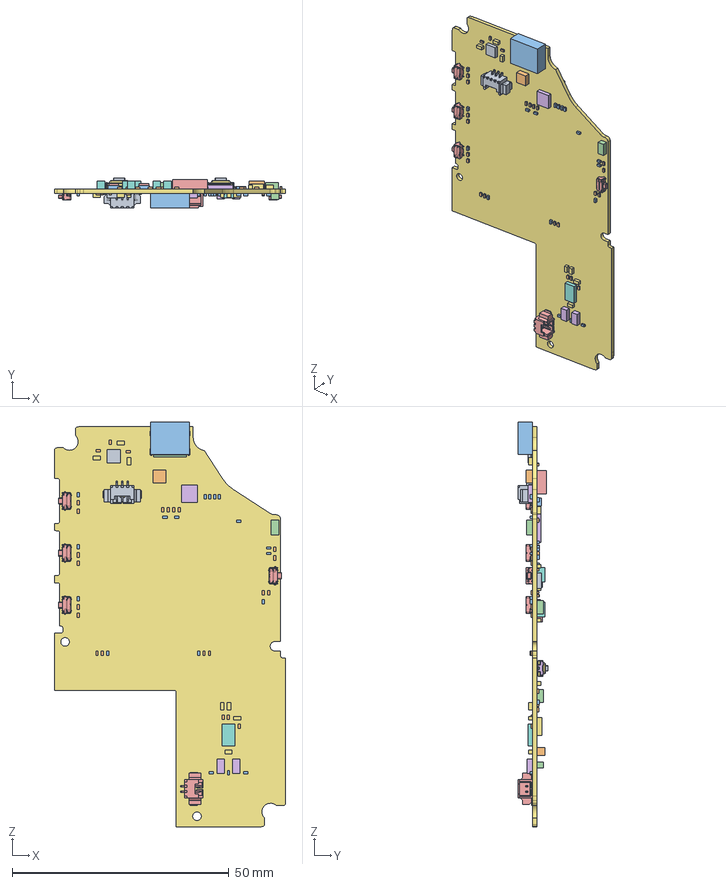
[picture p12: CAD file, 2026-10-13]
hardware/rev-b/3d/main-revb-populated-bodyv6.13.step
53.4 x 7.02 x 93.4 mm
