ZhangHanDong/openwalkietalkie/hardware/rev-b/models/RC0402FR-07604KL.step

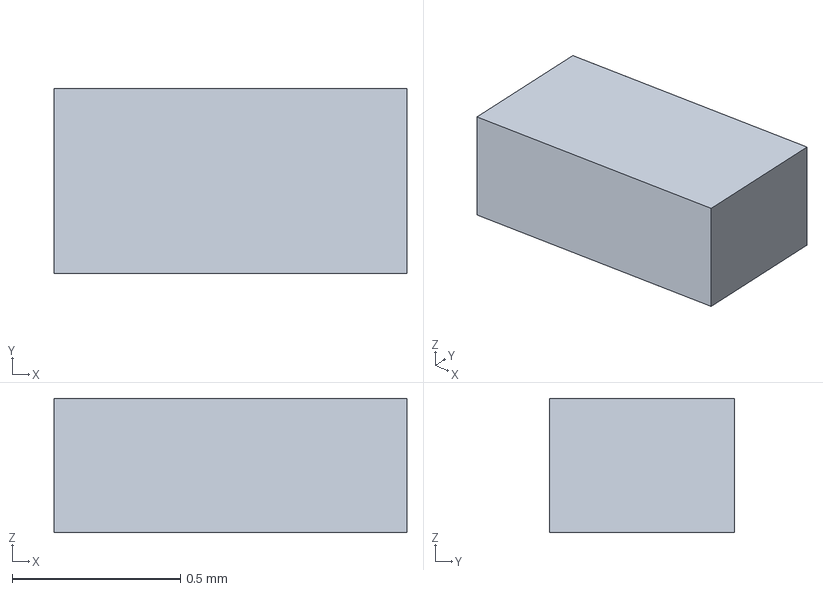
[picture p13: CAD file, 2026-10-13]
hardware/rev-b/models/RC0402FR-07604KL.step
1.05 x 0.55 x 0.4 mm
