ZhangHanDong/openwalkietalkie/hardware/rev-b/models/MP34DT05TR-A.step

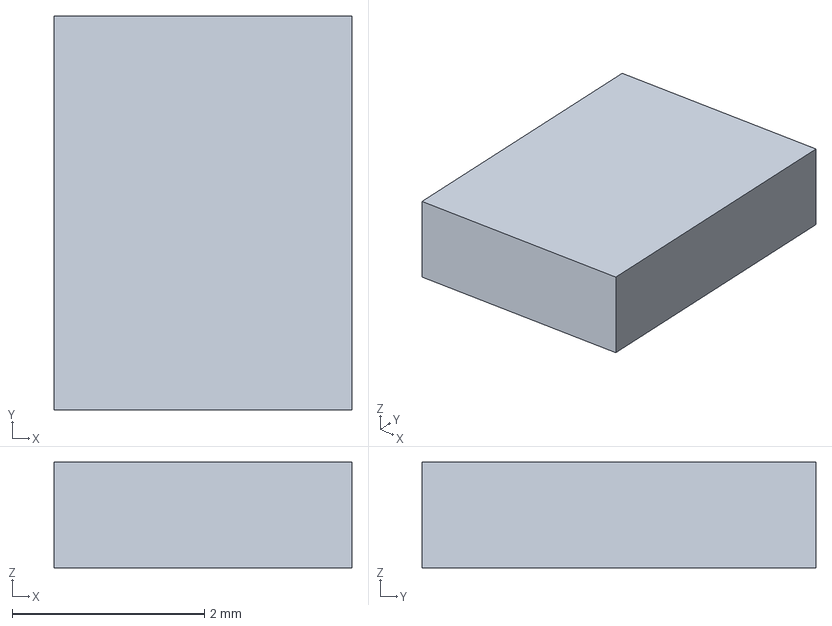
[picture p14: CAD file, 2026-10-13]
hardware/rev-b/models/MP34DT05TR-A.step
3.10 x 4.10 x 1.10 mm
