ZhangHanDong/openwalkietalkie/hardware/rev-b/models/DFE201612E-2R2M_P2.step

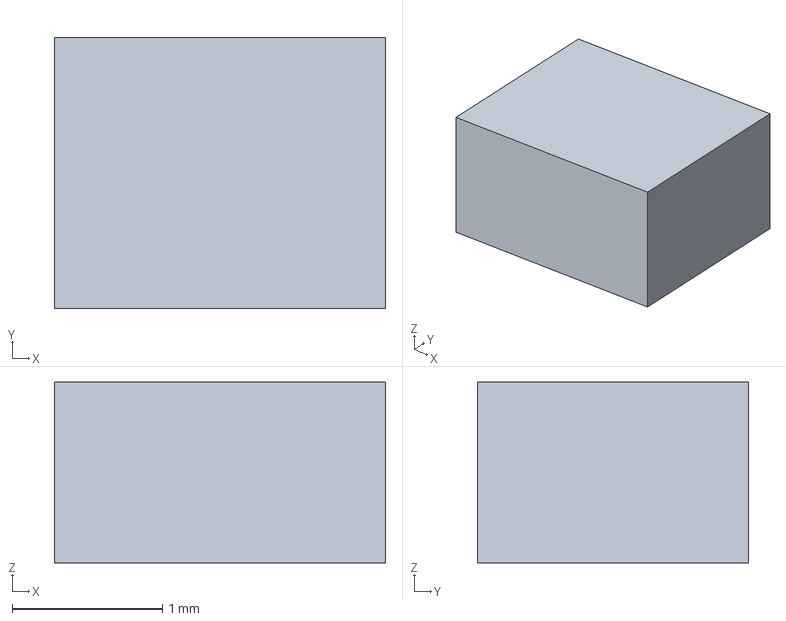
[picture p15: CAD file, 2026-10-13]
hardware/rev-b/models/DFE201612E-2R2M_P2.step
2.20 x 1.80 x 1.20 mm
