ZhangHanDong/openwalkietalkie/hardware/rev-a/pcb-release-bodyv5-20260917-r3/3d/main-populated-bodyv5.step

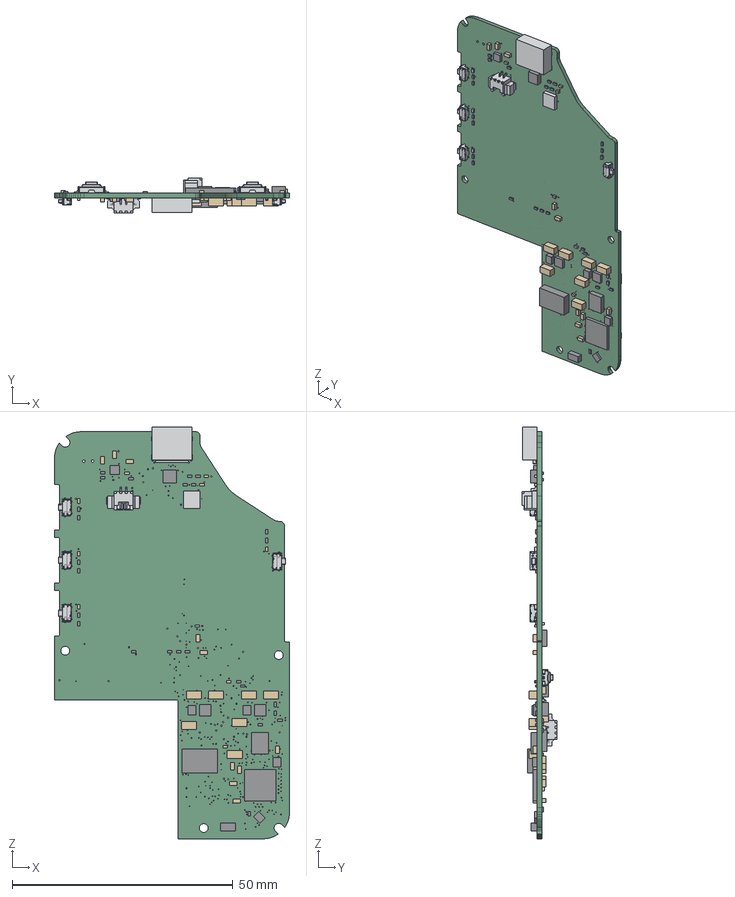
[picture p16: CAD file, 2026-10-13, an earlier design]
hardware/rev-a/pcb-release-bodyv5-20260917-r3/3d/main-populated-bodyv5.step
53.4 x 7.90 x 93.4 mm
PCB_finished_stackup_envelope
AE1
C1
C10
C11
C12
C13
C14
C15
C16
C17
C18
C19
C2
C20
C21
C22
C23
C24
C25
C26
C27
C28
C29
C3
C30
C31
C32
C33
C34
C35
C36
C37
C38
C39
C4
C40
C41
C42
C43
C44
C45
C46
C47
C48
C49
C5
C50
C51
C6
C7
C8
C9
J1
J2
J3
J5
L1
L2
L3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
