ZhangHanDong/openwalkietalkie/hardware/rev-a/pcb-release-bodyv6-20260922-r4/source/main/mechanical/main-mechanical.dxf

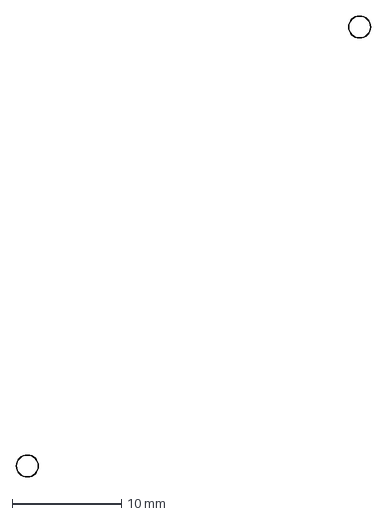
[picture p17: CAD file, 2026-10-13, an earlier design]
hardware/rev-a/pcb-release-bodyv6-20260922-r4/source/main/mechanical/main-mechanical.dxf
32.4 x 42.2 mm
