ZhangHanDong/openwalkietalkie/hardware/rev-a/pcb-release-bodyv6.13-20260923-r6/source/main/mechanical/main-outline.dxf

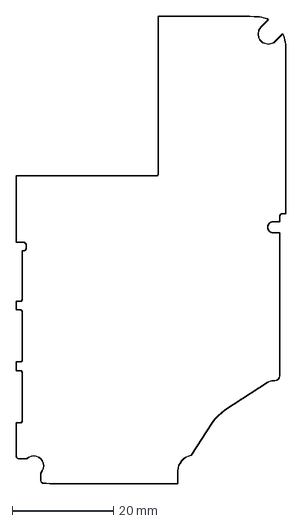
[picture p18: CAD file, 2026-10-13, an earlier design]
hardware/rev-a/pcb-release-bodyv6.13-20260923-r6/source/main/mechanical/main-outline.dxf
53.4 x 92.4 mm
