ZhangHanDong/openwalkietalkie/hardware/rev-a/pcb-release-bodyv5-20260917-r3/3d/bodyv5-fit-assembly.step

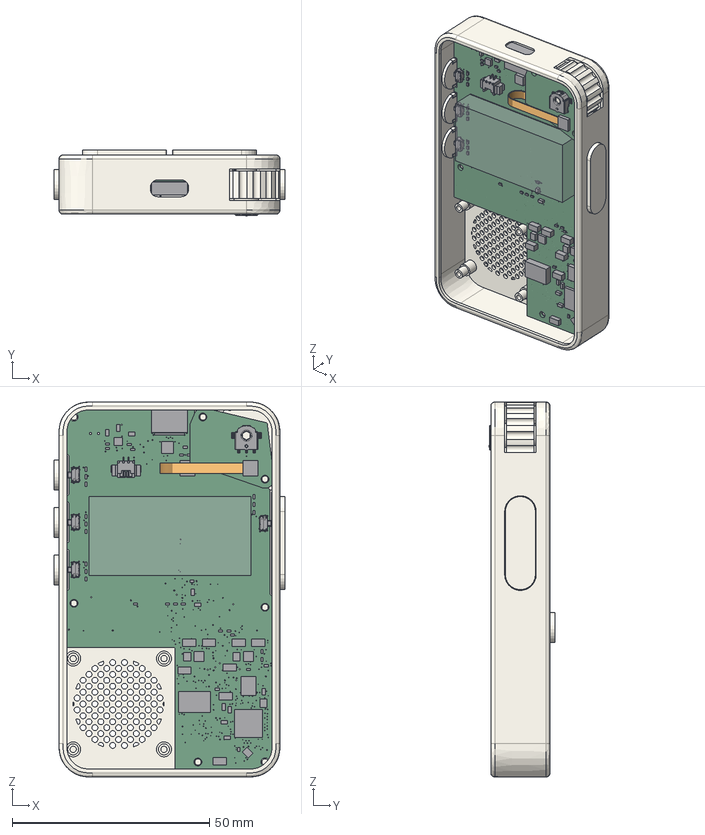
[picture p20: CAD file, 2026-10-13, an earlier design]
hardware/rev-a/pcb-release-bodyv5-20260917-r3/3d/bodyv5-fit-assembly.step
58.4 x 16.6 x 95.0 mm
MainCase
Wheel
PTT
Enter
Cancel
Shift
MacroLeft
MacroRight
main_PCB
encoder_PCB
main_AE1
main_C1
main_C10
main_C11
main_C12
main_C13
main_C14
main_C15
main_C16
main_C17
main_C18
main_C19
main_C2
main_C20
main_C21
main_C22
main_C23
main_C24
main_C25
main_C26
main_C27
main_C28
main_C29
main_C3
main_C30
main_C31
main_C32
main_C33
main_C34
main_C35
main_C36
main_C37
main_C38
main_C39
main_C4
main_C40
main_C41
main_C42
main_C43
main_C44
main_C45
main_C46
main_C47
main_C48
main_C49
main_C5
main_C50
main_C51
main_C6
main_C7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
