ZhangHanDong/openwalkietalkie/hardware/rev-a/pcb-release-bodyv5-20260917-r3/source/main/mechanical/main-mechanical.dxf

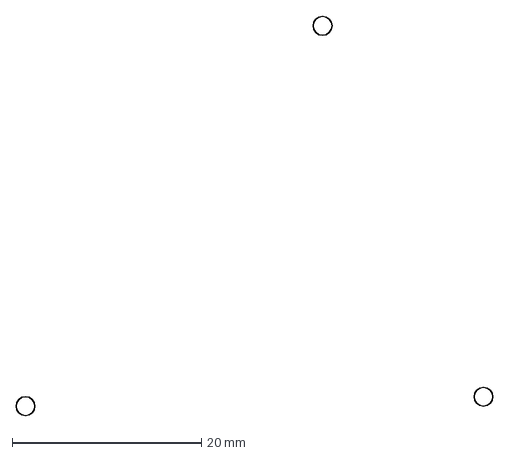
[picture p21: CAD file, 2026-10-13, an earlier design]
hardware/rev-a/pcb-release-bodyv5-20260917-r3/source/main/mechanical/main-mechanical.dxf
50.4 x 42.2 mm
