ZhangHanDong/openwalkietalkie/hardware/rev-a/pcb-release-bodyv6-20260922-r4/source/main/mechanical/main-outline.dxf

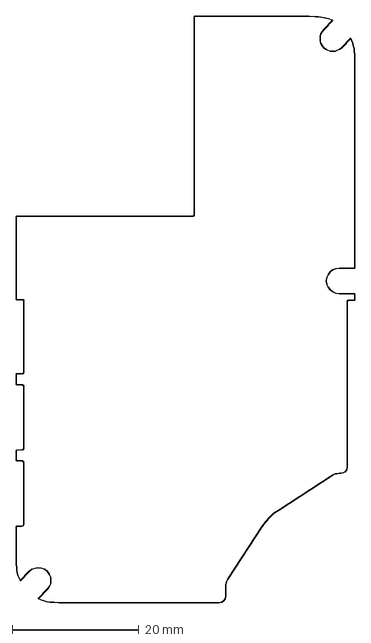
[picture p22: CAD file, 2026-10-13, an earlier design]
hardware/rev-a/pcb-release-bodyv6-20260922-r4/source/main/mechanical/main-outline.dxf
53.4 x 92.4 mm
