ZhangHanDong/openwalkietalkie/(list of files, cad)

Other CAD files:
hardware/rev-b/3d/main-revb-populated-native.step
hardware/rev-b/models/RC0402FR-075K1L.step
hardware/rev-a/pcb-release-bodyv5-20260917-r3/source/main/mechanical/main-outline.dxf
hardware/rev-a/pcb-release-bodyv6-20260922-r4/3d/main-populated-bodyv6.step
hardware/rev-a/pcb-release-bodyv6-20260922-r4/3d/main-populated-native.step
hardware/rev-a/pcb-release-bodyv6.9-20260922-r5/3d/main-populated-bodyv6.9.step
hardware/rev-a/mechanical-source/case/BodyV5-USB-face-battery-fit.f3d
hardware/rev-a/mechanical-source/case/BodyV5-USB-face-battery-fit.step
hardware/rev-a/mechanical-source/case/BodyV6.12.f3d
hardware/rev-a/mechanical-source/case/BodyV6.12.step
hardware/rev-a/mechanical-source/case/BodyV6.13.f3d
hardware/rev-a/mechanical-source/case/BodyV6.13.step
hardware/rev-a/mechanical-source/case/BodyV6.9.f3d
hardware/rev-a/mechanical-source/case/BodyV6.9.step
hardware/rev-a/mechanical-source/case/BodyV6.f3d
hardware/rev-a/mechanical-source/case/BodyV6.step
hardware/rev-a/mechanical-source/display/FPC3-H0175Y003MT006-1_V0.dxf
hardware/rev-a/mechanical-source/display/H0216F002AMT003A_V2.dxf
hardware/rev-a/pcb-release-bodyv5-20260917-r3/3d/encoder-populated-bodyv5.step
hardware/rev-a/pcb-release-bodyv5-20260917-r3/3d/encoder-populated-native.step
hardware/rev-a/pcb-release-bodyv5-20260917-r3/3d/interboard-cable-envelope-bodyv5.step
hardware/rev-a/pcb-release-bodyv5-20260917-r3/3d/main-populated-native.step
hardware/rev-a/pcb-release-bodyv5-20260917-r3/models/CC0603KRX5R6BB475.step
hardware/rev-a/pcb-release-bodyv5-20260917-r3/models/E1SB48E001G00E.step
hardware/rev-a/pcb-release-bodyv5-20260917-r3/models/FH34SRJ-4S-0.5SH_99_.step
hardware/rev-a/pcb-release-bodyv5-20260917-r3/models/RC0402FR-0722KL.step
hardware/rev-a/pcb-release-bodyv5-20260917-r3/models/RT6150BGQW.step
hardware/rev-a/pcb-release-bodyv5-20260917-r3/models/SPM1423HM4H-B.step
hardware/rev-a/pcb-release-bodyv5-20260917-r3/source/encoder/mechanical/encoder-mechanical.dxf
hardware/rev-a/pcb-release-bodyv6-20260922-r4/3d/bodyv6-fit-assembly.step
hardware/rev-a/pcb-release-bodyv6-20260922-r4/3d/encoder-populated-bodyv6.step
hardware/rev-a/pcb-release-bodyv6-20260922-r4/models/8.03A5.031250.step
hardware/rev-a/pcb-release-bodyv6-20260922-r4/models/C3216X7R1C106K160AC.step
hardware/rev-a/pcb-release-bodyv6-20260922-r4/models/CC0402JRNPO9BN102.step
hardware/rev-a/pcb-release-bodyv6-20260922-r4/models/CC0402KRX5R6BB474.step
hardware/rev-a/pcb-release-bodyv6-20260922-r4/models/CC0402KRX7R7BB104.step
hardware/rev-a/pcb-release-bodyv6-20260922-r4/models/PTS636SM25SMTRLFS.step
hardware/rev-a/pcb-release-bodyv6-20260922-r4/models/RC0402FR-071KL.step
hardware/rev-a/pcb-release-bodyv6-20260922-r4/models/RC0402FR-071ML.step
hardware/rev-a/pcb-release-bodyv6-20260922-r4/models/RC0402FR-0722RL.step
hardware/rev-a/pcb-release-bodyv6-20260922-r4/models/RC0402FR-0786K6L.step
hardware/rev-a/pcb-release-bodyv6-20260922-r4/models/SGM41562SAXTYH10G_TR.step
hardware/rev-a/pcb-release-bodyv6-20260922-r4/models/TYPE-C-31-M-12.step
hardware/rev-a/pcb-release-bodyv6-20260922-r4/models/_superseded-OK-F302-31115.step
hardware/rev-a/pcb-release-bodyv6.13-20260923-r6/3d/bodyv6.13-encoder-wheel-fit-assembly.step
hardware/rev-a/pcb-release-bodyv6.13-20260923-r6/3d/bodyv6.13-fit-assembly.step
hardware/rev-a/pcb-release-bodyv6.13-20260923-r6/3d/encoder-populated-bodyv6.13.step
hardware/rev-a/pcb-release-bodyv6.13-20260923-r6/3d/encoder-populated-native.step
hardware/rev-a/pcb-release-bodyv6.13-20260923-r6/3d/encoder-wheel-populated-bodyv6.13.step
hardware/rev-a/pcb-release-bodyv6.13-20260923-r6/3d/encoder-wheel-populated-native.step
hardware/rev-a/pcb-release-bodyv6.13-20260923-r6/3d/main-populated-bodyv6.13.step
hardware/rev-a/pcb-release-bodyv6.13-20260923-r6/3d/main-populated-native.step
hardware/rev-a/pcb-release-bodyv6.13-20260923-r6/encoder-wheel/mechanical/wheel-with-encoder-cavity-bodyv6.13.step
hardware/rev-a/pcb-release-bodyv6.13-20260923-r6/models/BQ24073RGTR.step
hardware/rev-a/pcb-release-bodyv6.13-20260923-r6/models/CC0603JRNPO9BN152.step
hardware/rev-a/pcb-release-bodyv6.13-20260923-r6/models/CC0603KRX5R6BB105.step
hardware/rev-a/pcb-release-bodyv6.13-20260923-r6/models/CC1206JRNPO8BN104.step
hardware/rev-a/pcb-release-bodyv6.13-20260923-r6/models/EC05E1220401.step
hardware/rev-a/pcb-release-bodyv6.13-20260923-r6/models/NS4150B.step
hardware/rev-a/pcb-release-bodyv6.13-20260923-r6/models/RC0402FR-07100KL.step
hardware/rev-a/pcb-release-bodyv6.13-20260923-r6/models/RC0402FR-0710KL.step
hardware/rev-a/pcb-release-bodyv6.13-20260923-r6/models/RC0402FR-072K55L.step
hardware/rev-a/pcb-release-bodyv6.13-20260923-r6/models/RC0402JR-070RL.step
hardware/rev-a/pcb-release-bodyv6.13-20260923-r6/models/SF32LB525UC6.step
hardware/rev-a/pcb-release-bodyv6.13-20260923-r6/models/USBLC6-2SC6.step
hardware/rev-a/pcb-release-bodyv6.9-20260922-r5/3d/bodyv6.9-fit-assembly.step
hardware/rev-a/pcb-release-bodyv6.9-20260922-r5/3d/encoder-populated-native.step
hardware/rev-a/pcb-release-bodyv6.9-20260922-r5/3d/main-populated-native.step
hardware/rev-a/pcb-release-bodyv6.9-20260922-r5/models/2450AT18B100E.step
hardware/rev-a/pcb-release-bodyv6.9-20260922-r5/models/BLM31PG601SN1L.step
hardware/rev-a/pcb-release-bodyv6.9-20260922-r5/models/CC0402JRNPO9BN331.step
hardware/rev-a/pcb-release-bodyv6.9-20260922-r5/models/CC0603KRX5R6BB225.step
hardware/rev-a/pcb-release-bodyv6.9-20260922-r5/models/CC0805KRX5R8BB106.step
hardware/rev-a/pcb-release-bodyv6.9-20260922-r5/models/RC0402FR-07442KL.step
hardware/rev-a/pcb-release-bodyv6.9-20260922-r5/models/RT6150B-33GQW.step
hardware/rev-a/pcb-release-bodyv6.9-20260922-r5/models/SKTDLDE010.step
hardware/rev-a/pcb-release-bodyv6.9-20260922-r5/models/TPS22918DBVR.step
hardware/rev-a/pcb-release-bodyv6.9-20260922-r5/models/W25Q128JVSIQ.step
hardware/rev-a/pcb-release-bodyv6.9-20260922-r5/models/WPN201610U4R7MT.step
hardware/rev-a/pcb-release-bodyv6.9-20260922-r5/source/encoder/mechanical/encoder-mechanical.dxf
hardware/rev-a/pcb-release-bodyv6.9-20260922-r5/source/encoder/mechanical/encoder-outline.dxf
