ZhangHanDong/openwalkietalkie/docs/mockups/5-usage-report.png

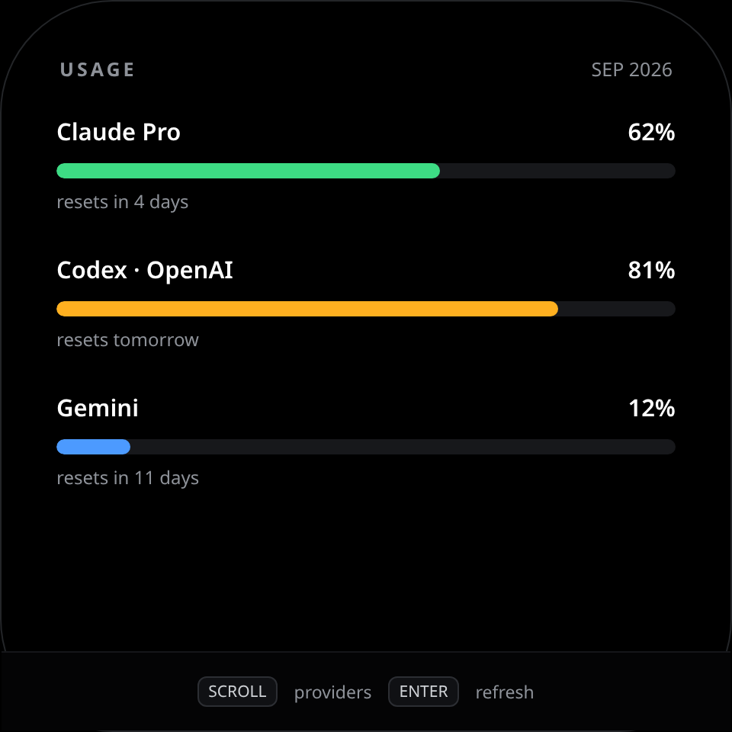
docs/mockups/5-usage-report.png
