ZhangHanDong/openwalkietalkie/hardware/rev-b/verification/review-2026-10-05.md

# Independent review of the Rev B release candidate (2026-10-05)

Six reviewers checked the first release candidate (mechanical/3D, RF,
audio, electrical, DFM, completeness) by measuring the board with pcbnew,
kicad-cli and the case STEP. Every blocker/major finding then went to a
separate verifier who tried to refute it. The table lists each finding that
needed action and what the released board does about it.

| ID | Severity (verified) | Finding | Disposition in the release |
|---|---|---|---|
| RF-1 / C2 | major (confirmed) | PANEL_D1/PANEL_D3 ran along the antenna ground edge (0.04 mm from the clearance, vias 0.28 mm from its corner). | **Partly fixed.** Re-routed to 0.31 mm (D1) and 0.42 mm (D3). Apart from the RF feed, GND and the DAC pair (RF-8), the nearest other copper is PANEL_RESET at R30, 2.38 mm; everything else is ≥ 3.1 mm. The panel bus could not be fitted west of the DAC pair with the other lines in place. Listed in README "Known limitations" with a BLE RSSI/PER test for the first build. |
| RF-2 | minor | The CPWG gap was 0.10 mm, not 0.20 mm: the "RF50 at the U5 pins" rule also matched the board-wide pours (≈45 Ω). | **Fixed.** The rule excludes zones; the refilled gap is 0.20 mm (≈49–52 Ω). |
| RF-3 | minor | Sparse GND stitching along the antenna clearance, CPWG fence gaps, few return vias at the RF layer change. | **Partly fixed:** 6 GND vias along the clearance's left edge and 1 below it, 4 fence vias in the gap where the DAC pair crosses the line. Candidates on the rest of the bottom edge, the jog's NE side and the RF via's N/E sides did not fit; those spots are taken by the RF network parts and fence. |
| RF-4 | minor | Crystal XO pad 0.43 mm from C53 (RF line) with no ground between. | **Open.** Inherent to the crystal/RF placement; README "Known limitations". |
| RF-5 | minor | A PANEL_CLK via 0.14 mm from Y1's XO pad, and PANEL_CLK under the crystal. | **Fixed.** PANEL_CLK re-routed on F/B only, with a B-side keep-out around Y1 and no inner-layer copper under the crystal (see FC-1). The nearest signal via is 0.78 mm (TOUCH_RESET) from a Y1 pad, edge to edge; GND vias come to 0.58 mm, which is fine. F-side traces (CAL, PANEL_CS, PANEL_D0, PANEL_TE, TOUCH_RESET) still cross the crystal's B-side courtyard, shielded by solid In1 and In2. |
| RF-6 | minor | RF shunt pads had no dedicated GND vias. | **Fixed.** One GND via beside each of C52.2, C53.2, L6.2, C58.2; these pads now have solid zone connection. |
| RF-7 | minor | Matching-network pads add untuned capacitance (solid plane under 0402 pads). | **Fixed.** Fill voids (pad + 0.2 mm) on In1 under R40, L6, R47, C58 and on In2 under C57, C52, C53. |
| RF-8 / AUD-5 | minor | DAC filter pair 0.9–2 mm from the antenna clearance (C2 pads 0.92 mm, tracks 1.17/1.32 mm; BLE TX buzz risk). | **Open.** README "Known limitations", with the bodge (33–100 pF at C3/C4). |
| RF-9 | info | README draft said no inner trace runs under the RF escapes / U5 EP. | **Fixed** in the README (In1 MCU_VSYS crosses under the pin-row escapes with In2 between). |
| AUD-1 | minor | The 0.5 mm summing-node DRC rule never applied (overridden by the later 0.3 mm rule). | **Fixed.** Rule moved last and widened to any non-audio, non-GND copper; DRC still 0. |
| AUD-2 / C4 / F3 | minor | PA01 is SiFli's default calibration/downloader signal pin, but TP3 had moved to PA00 and PA01 drives AMP_ENABLE. | **Documented.** The swap back (CAL on PA01, AMP_ENABLE on PA00) was attempted but would not route. The calibration tool's signal pin is configurable; README and ORDER-NOTES say to set it to PA00 (TP3) or use OTA calibration. |
| AUD-3 / F5 | minor | Flash 100 nF C22 fed through the AVDD33_AUD star node (11.5 mm), with a stub 0.22 mm from BUCK_LX. | **Fixed.** C22 connects straight to U4 pin 8 (1 mm). The stub is gone, and with it the checker's MCU_LDO1/BUCK_LX warning. |
| AUD-4 | info | DAC pair stitching sparse (up to 8.6 mm). | **Improved.** 15 GND vias added beside the pair. |
| AUD-7 | info | U1 GND pin 7 has one GND via within 1.5 mm. | **Open** (a second via does not fit inside the island); the checker passes. |
| F1 | minor (confirmed) | Firmware drives PA20; the amp enable is now PA01. | Firmware change listed in README "Firmware changes". |
| F2 | minor | CHG on PA33 is not read by firmware. | Firmware change listed. |
| F4 | minor | U5 VCC cap C28 is 4 mm away through a 0.12 mm neck. | **Partly improved:** the F link is 0.2 mm where it fits. Listed in README. |
| F8 | minor | C20/C21 are 5.6/8.5 mm from their U3 pins. | **Open**, listed in README (the panel FPC has its own decoupling). |
| F7 | info | Amp gain −13 dB with 100k Rin. | **Moot.** R4/R5 went back to r6's 22k on 2026-10-06 (see below). |
| F6, F10, F11 | info | Touch powered in soft-off; USB500 input limit; NTC required. | Listed in README (firmware / bring-up notes). |
| DFM-1 | not an issue (verifier) | Via-in-pad needs filled & capped vias. | ORDER-NOTES specifies epoxy filled & capped and lists the 48 vias. |
| DFM-2 / C3 | info (verifier) | Y1 has no LCSC part. | ORDER-NOTES Y1 row, with the candidate and r6's note. |
| DFM-4 | minor | CAL via in U5 pin 51's pad. | **Open:** filled & capped; CAL only feeds TP3. |
| DFM-5 | minor | Paste apertures on DNP pads. | **Fixed:** no paste on C52, C53, C58, L6, R44. |
| DFM-6 | minor | U5 pin-1 silk dot 0.106 mm from a mask opening. | **Fixed:** moved 0.05 mm out. |
| DFM-7 / C5 | minor | No revision marking. | **Fixed:** "OpenWalkieTalkie main Rev B / 2026-10" on F silk; title block revision B. |
| DFM-8 | minor | Orientation-list offsets used a different method from r6. | **Fixed:** pad bounding-box centre (J1/J3 0.60, J5 1.48, SW 0.55, as r6). |
| DFM-11 | info | TP/MH not flagged exclude-from-position/BOM. | **Fixed.** |
| C1 / DFM-3 | minor | README / ORDER-NOTES missing. | **Fixed.** |
| C6 / F12 | minor | Duplicate track segments. | **Fixed:** 49 removed, plus 3 more left by the FC-1 re-route. |
| FC-1 | minor (final check) | After the RF-5 re-route, PANEL_CLK ran 3.69 mm on In2 directly under the XO/XI escape traces. | **Fixed.** PANEL_CLK and PANEL_D2 re-routed by the rip-up router with In2 barred under Y1; PANEL_CLK is now F/B only (2 vias), and no inner-layer track enters Y1's area. DRC 0/0 and the audio check (0 errors) re-run. |
| FC-2 | minor (final check) | The R39 GND via at (33.22, 30.0) made In2 leave a 0.1 mm² sliver between USB_MCU_P/N; deleting the via instead left R39.2 and a B pour piece unconnected. | **Fixed.** Via kept; an In2 no-fill rule area covers the sliver, so both planes fill as one piece. |
| FC-3 | info (final check) | README wording: the F caps "directly behind U5", "every other net ≥ 2.6 mm", inner-layer count, missing USB500 note. | **Fixed** in the README. |
| FC-4 | info (claims check) | A last pass measured every number in the release docs against the board and fab files: In1 MCU_LDO1 also runs under R1/the DAC pair (In2 between); U4's height allowance is 2.9 mm under the folded flex; PA33 can be a wake pin; r6's C19 path was 10.8 mm; the XO/BT_RF spacing wording; the audio coupling figure; 3 duplicate segments; the order-number option; U6's pin-1 mark; J2/U3 offsets. | **Fixed** in the README, ORDER-NOTES, this table and the board (duplicates removed; DRC 0/0, audio 0 errors re-run). |
| M5 | info | No B-side keep-out over the right case rib. | Not needed for this release (no B part within 1.5 mm); noted. |

Change after the review (2026-10-06b): the board's **bottom-right corner was
rounded to match the top-left** at the user's request. The sharp diagonal
cut-ins were replaced with the top-left corner's smooth tangent fillets (a
180-degree-rotated copy about the board centre), keeping the 2.0 mm case
locating lobe. It only removes copper-free board material (~3 mm2, verified by
a board-polygon set difference: added 0.002 mm2); no part, net or track moved
(BOM/CPL/netlist unchanged), DRC is 0/0, the audio check is 0 errors, and the
3D fit against BodyV6.13 shows no new interference and no board-case
intersection. A case section at the board plane confirmed the fit and also that
the case's bottom-right pocket wall is not symmetric with the top-left, so the
board now sits with a small gap (up to ~2 mm) at that corner; matching the case
cosmetically is a separate Fusion edit, not done here.

Change after the review (2026-10-06): R4/R5 went back from 100k to r6's
22k, because R_in is not what caused the r6 hiss. They stay at the NS4150B
input pins. Only the BOM line, the position-file values and the 3D models
changed; copper, mask, silk and paste are identical. DRC 0/0 and the audio
check (0 errors) were re-run.

What the reviewers confirmed as correct:
- All seven requests implemented as stated, with the netlist diff matching the intent exactly.
- J3 pinout and footprint (KiCad stock 53261-0371 geometry).
- Switch centring.
- 3D fit and mounting holes as r6, and B-side heights. (The bottom-right corner was later rounded to match the top-left; see the change note below.)
- Power-path resistances, all lower than r6.
- No plane islands.
- Fab outputs complete and matching the board, with JLC 4-layer limits met with margin.
