ZhangHanDong/openwalkietalkie/hardware/rev-b/scripts/postreview/fix_rules.txt

See ../board_rules.py (the rules text written to main-revb.kicad_dru). Old rules:
  RF50 at the U5 pins: condition matched zones intersecting U5's courtyard (the board-wide pours) -> 0.1 mm everywhere.
  audio summing nodes was listed before audio analog spacing, so the 0.3 mm rule won for AudioAnalog-to-Default copper.
