ZhangHanDong/openwalkietalkie/hardware/rev-a/pcb-release-bodyv6-20260922-r4/assembly-notes/FH34SRJ-4S-official-drawing.pdf

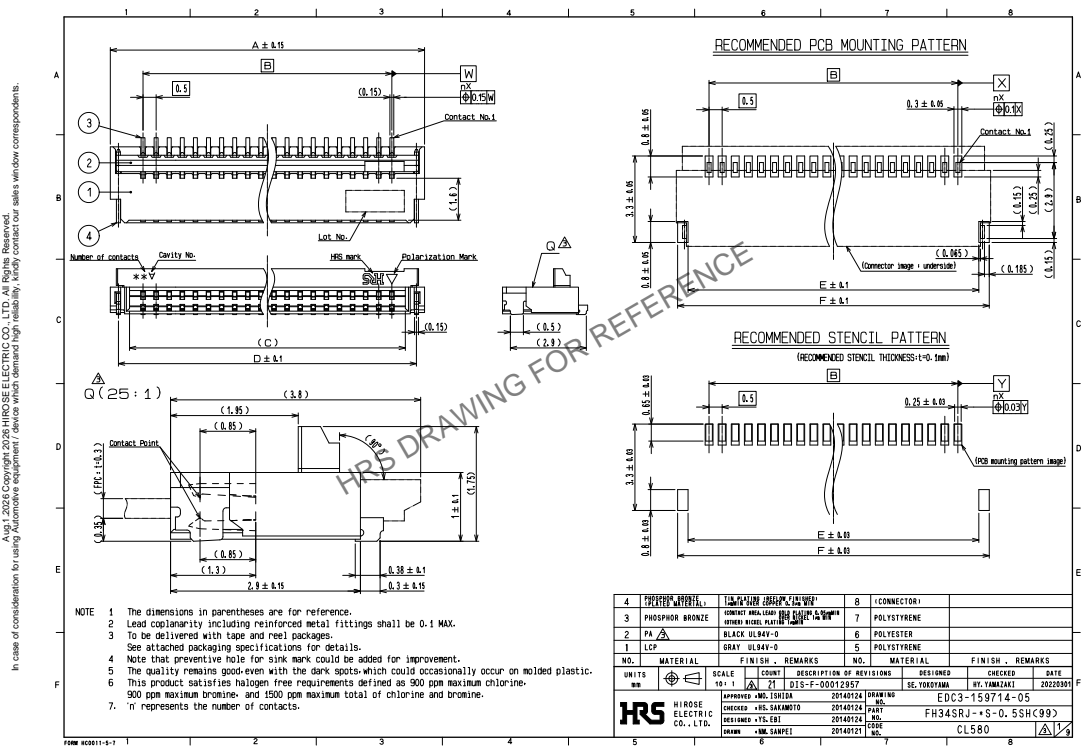
[picture p24: page 1]

HRS DRAWING FOR REFERENCE

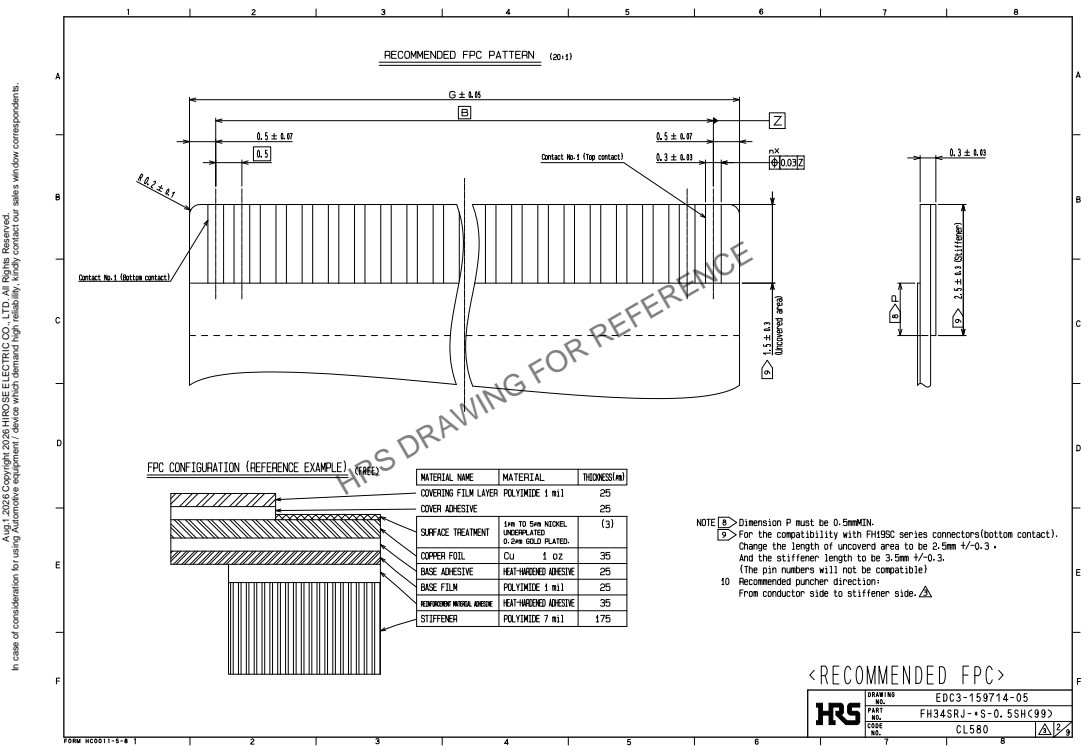
[picture p25: page 2]

HRS DRAWING FOR REFERENCE

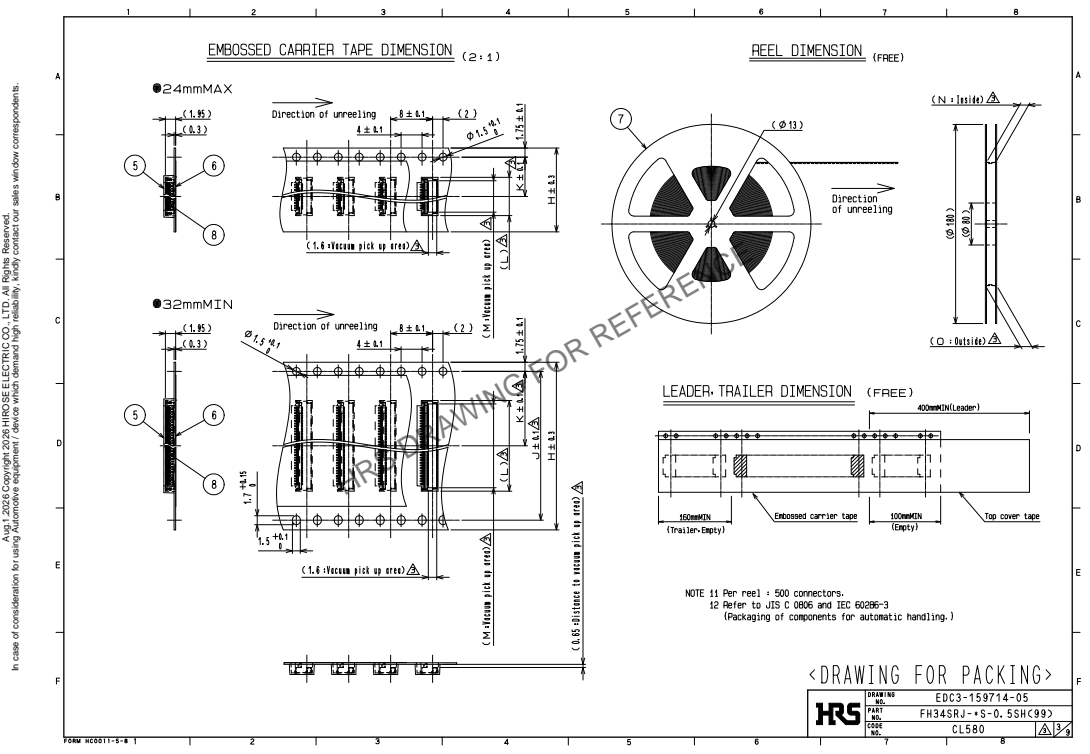
[picture p26: page 3]

HRS DRAWING FOR REFERENCE

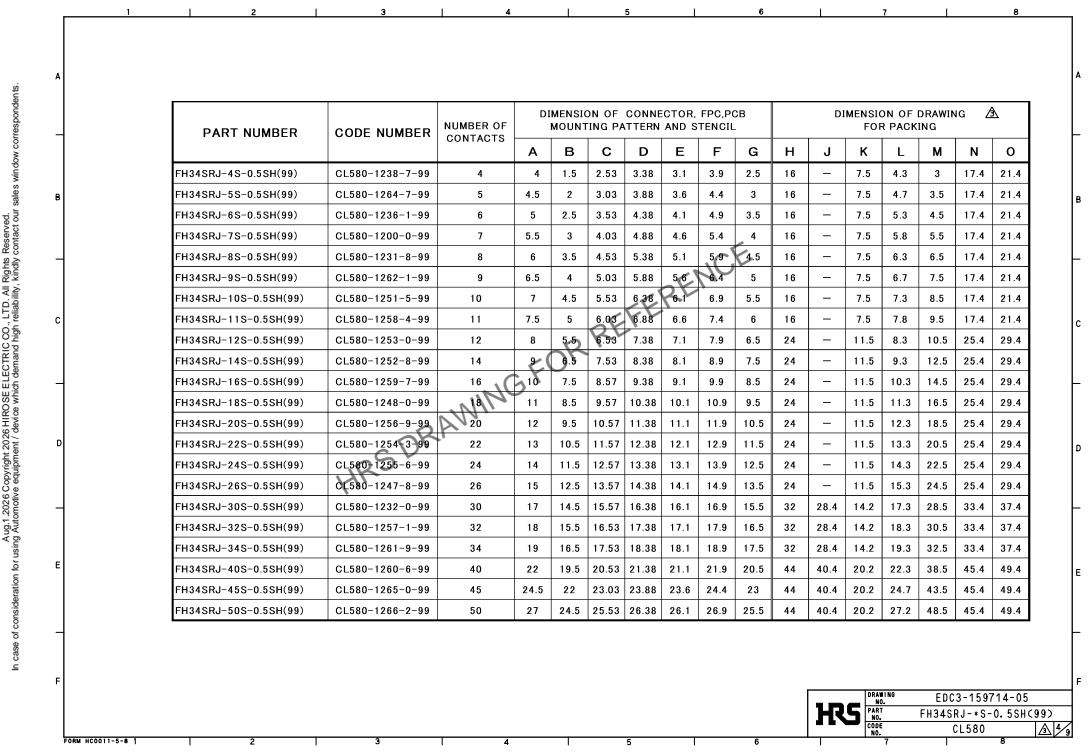
[picture p27: page 4]

HRS DRAWING FOR REFERENCE

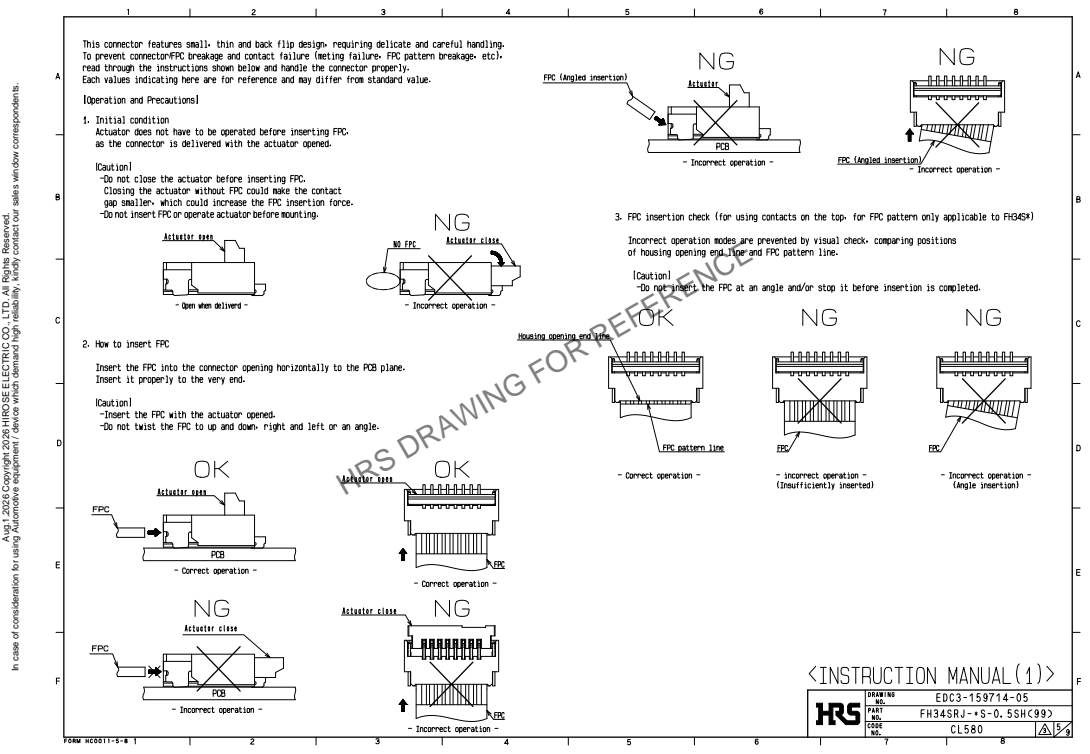
[picture p28: page 5]

HRS DRAWING FOR REFERENCE

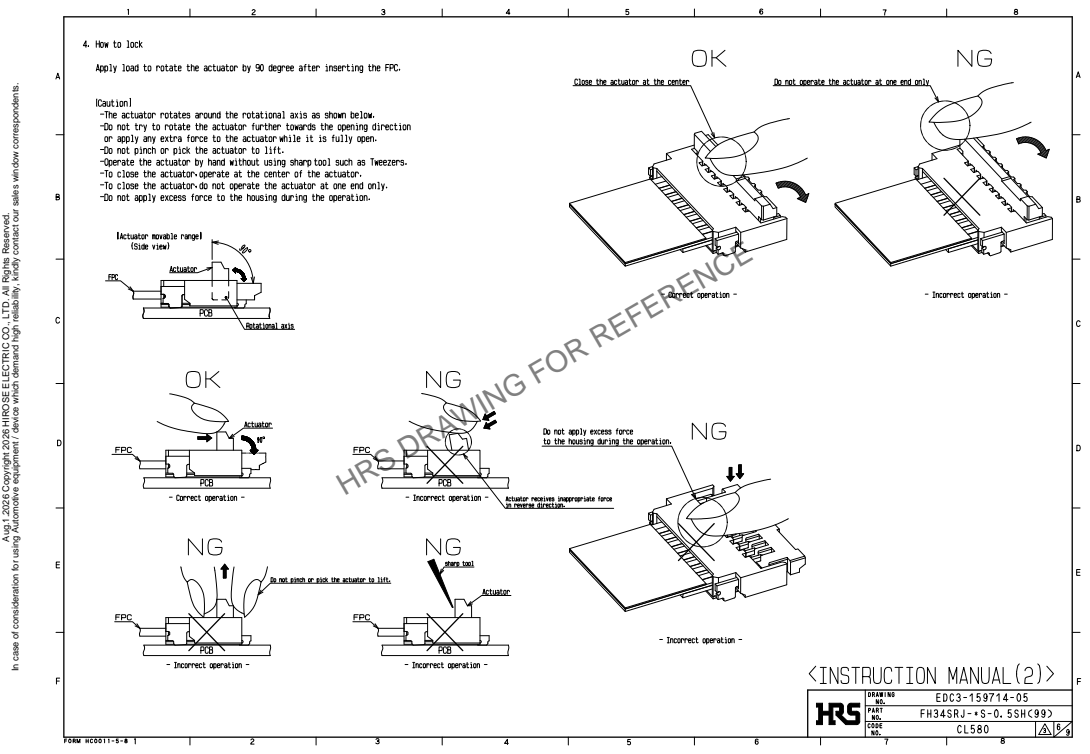
[picture p29: page 6]

HRS DRAWING FOR REFERENCE

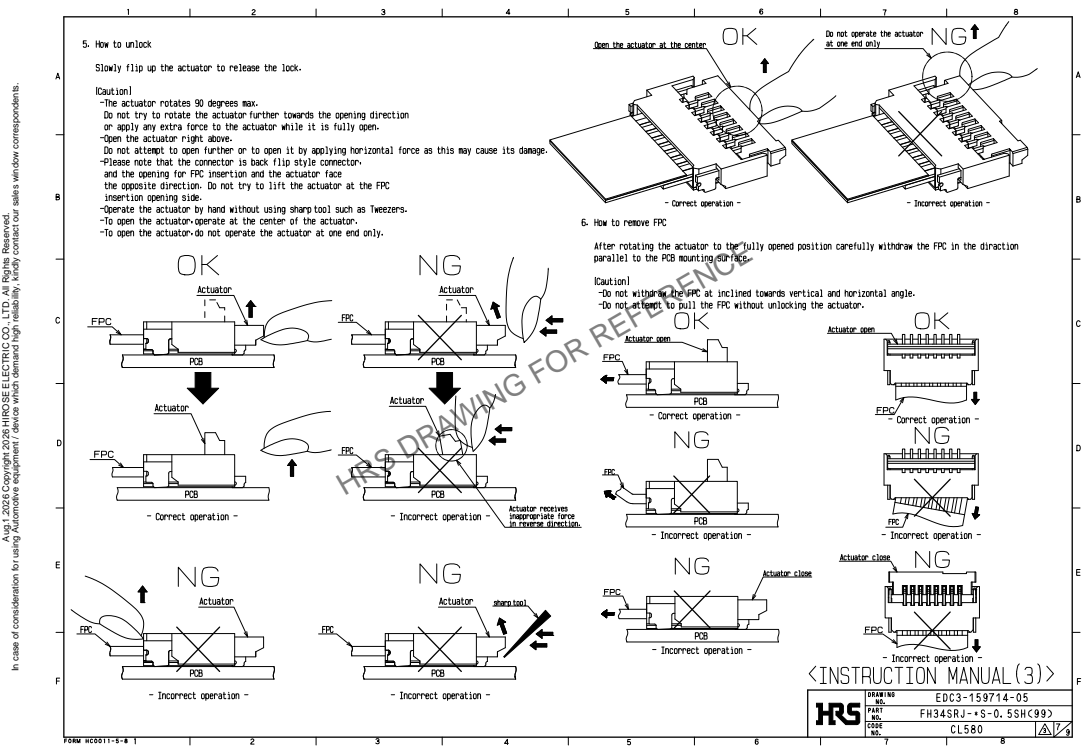
[picture p30: page 7]

HRS DRAWING FOR REFERENCE

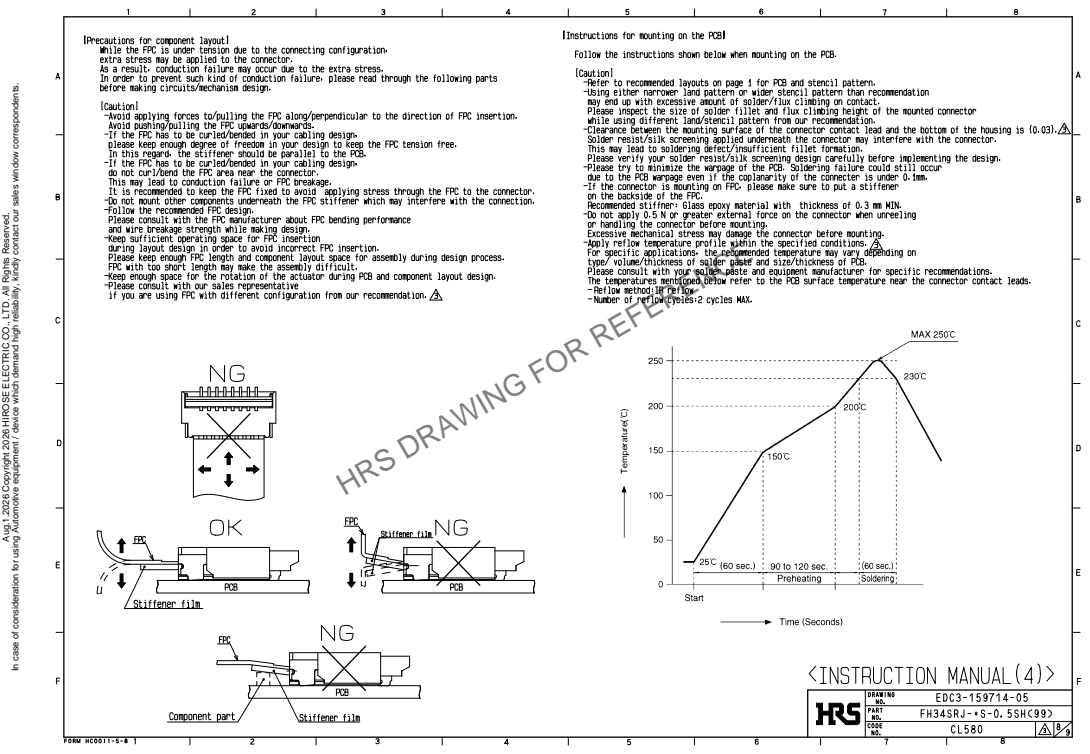
[picture p31: page 8]

HRS DRAWING FOR REFERENCE

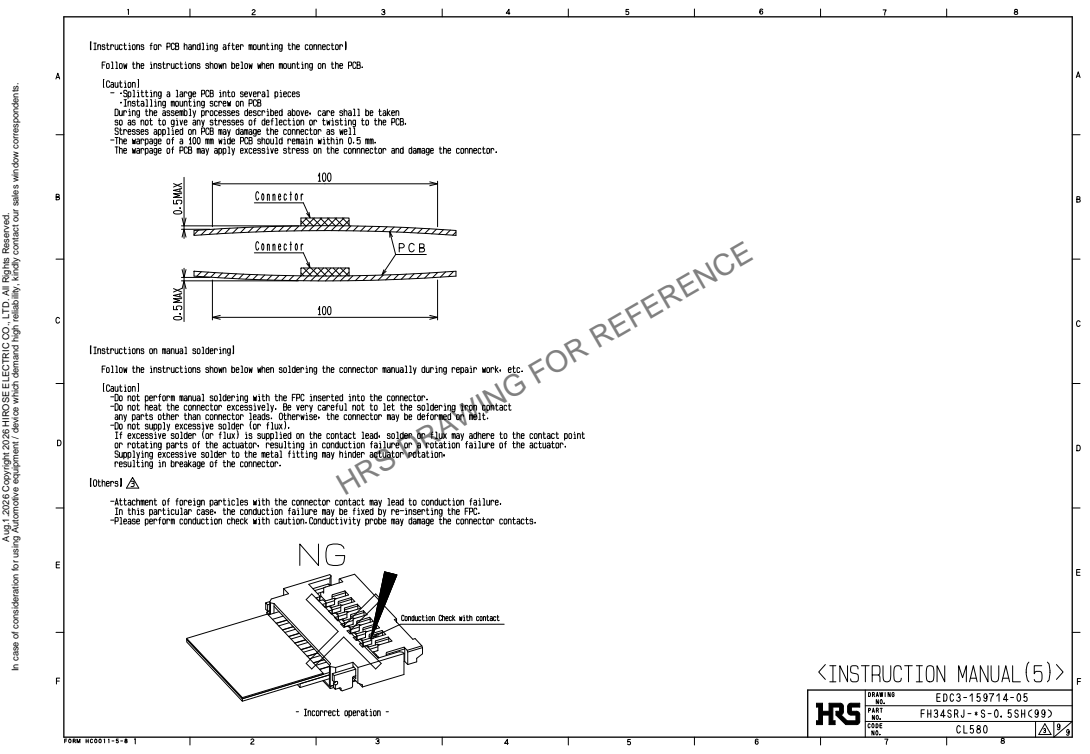
[picture p32: page 9]

HRS DRAWING FOR REFERENCE
