ZhangHanDong/openwalkietalkie/hardware/rev-b/main/main-revb.kicad_pcb

## KiCad design hardware/rev-b/main/main-revb.kicad_pcb (2026-10-15)

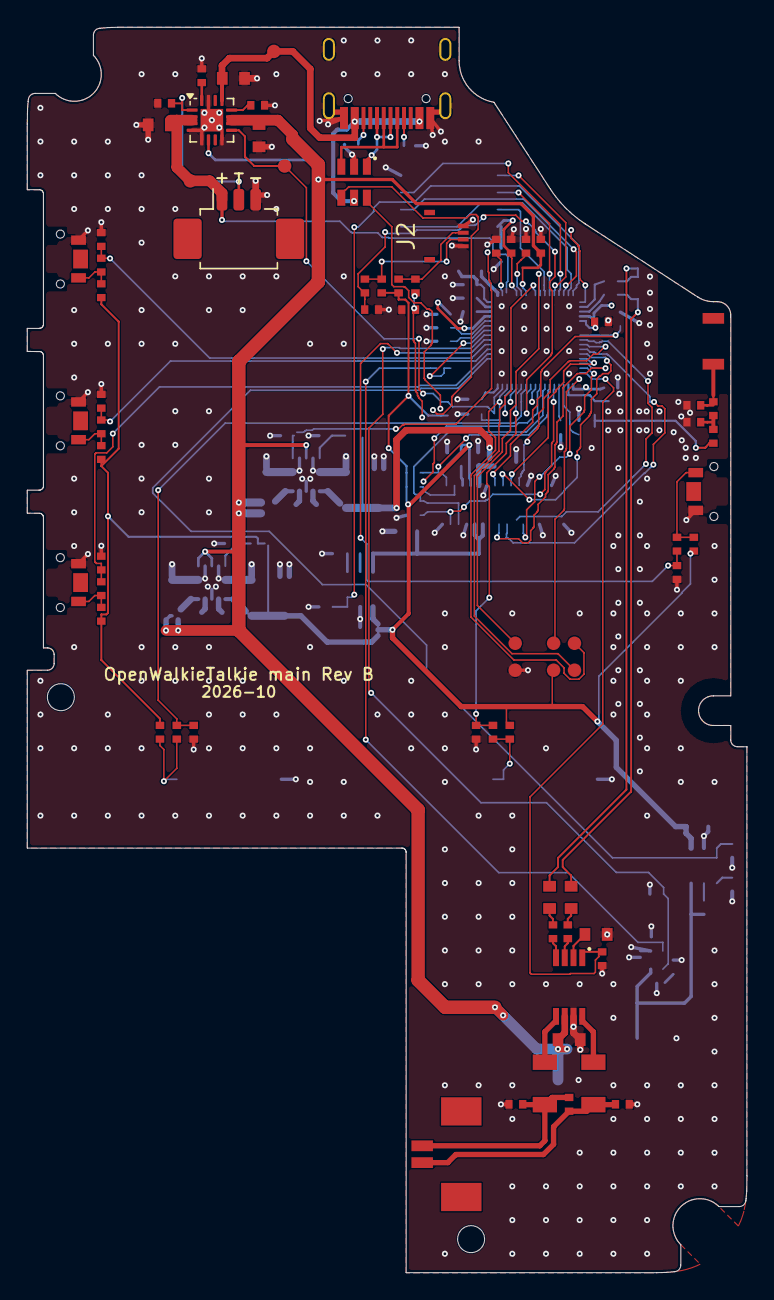
[picture p33: board main-revb.kicad_pcb from above]

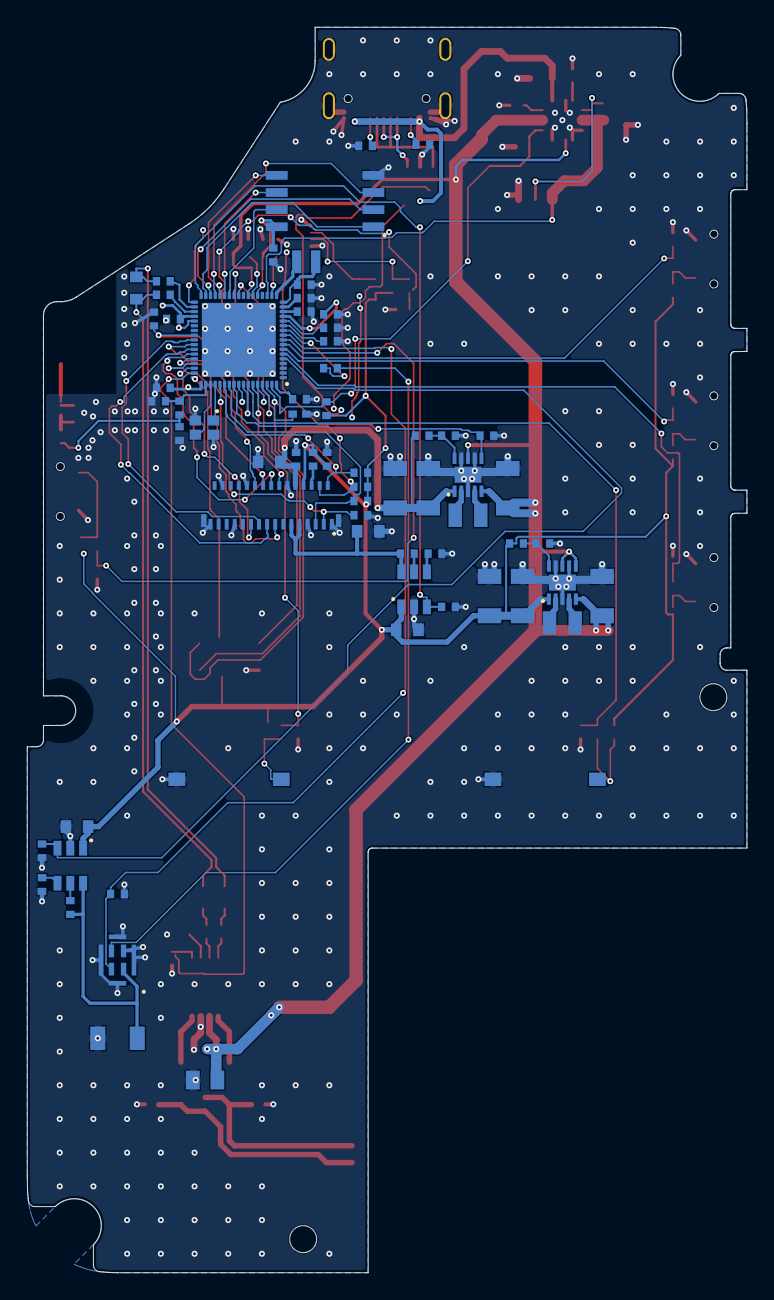
[picture p34: board main-revb.kicad_pcb from below]

Board: 4 copper layers, 53.4 x 92.4 mm, 142 parts (67 on the bottom side), 105 nets.

Parts:
AE1: CeramicAntenna2450; antenna-FP_ANT_2450AT18B100E
C1, C3, C4, C5, C11, C21, C49: 1uF; passive-CHIP_0603
C2: 1.5nF; passive-CHIP_0603
C6, C32, C33, C34, C35, C36, C37, C38, C39, C50: 1nF; passive-CHIP_0402
C7: 100nF; passive-CHIP_1206
C8, C9, C10: 330pF; passive-CHIP_0402
C12: 10uF; passive-CHIP_0805
C13, C17, C28, C29, C30: 4.7uF; passive-CHIP_0402
C14, C16, C23, C24, C27, C31: 2.2uF; passive-CHIP_0402
C15, C26: 1uF; passive-CHIP_0402
C18, C40, C41, C48: 4.7uF; passive-CHIP_0603
C19, C20, C22: 100nF; passive-CHIP_0402
C25: 470nF; passive-CHIP_0402
C42, C43, C44, C45, C46, C47: 10uF; passive-CHIP_1206
C52, C53, C58: NF; passive-CHIP_0402
C57: 15pF; passive-CHIP_0402
J1: PicoBlade2Pin; openmicrodial_rev_a-FP_MOLEX_53261_0271
J2: FH34SRJ_4S_0P5SH_99; openmicrodial_rev_a-FP_HIROSE_FH34SRJ_4S
J3: 53261-0371; openmicrodial_rev_b-FP_MOLEX_53261_0371
J5: USB_C_Receptacle_2_0; usb-connectors-type_c-FP_USB_C_Receptacle_HRO_TYPE_C_31_M_12
L1, L2: SpeakerFerrite600R; openmicrodial_rev_a-FP_MURATA_BLM31PG_1P5A_REFLOW
L3: 4.7uH; passive-FP_L_WPN201610U_2016Metric
L4, L5: 2.2uH; passive-FP_L_0806_2016Metric
L6: NF; passive-CHIP_0402
MH2, MH4: Mounting hole; openmicrodial_rev_b-MountingHole_2.0mm_NPTH
MK1: MP34DT05TR-A; openmicrodial_rev_a-FP_ST_MP34DT05_HCLGA_3x4
R1, R2, R8, R20, R21, R22, R23, R24, R25, R26, R27, R35: 1kohm; passive-CHIP_0402
R3, R7, R12, R13, R14, R15, R16, R17, R18, R19, R30, R41, R45, R46: 100kohm; passive-CHIP_0402
R4, R5: 22kohm; passive-CHIP_0402
R6: 22ohm; passive-CHIP_0402
R9, R34, R36, R39, R42: 1Mohm; passive-CHIP_0402
R10, R11: 5.1kohm; passive-CHIP_0402
R28, R29, R44: 10kohm; passive-CHIP_0402
R31: 86.6kohm; passive-CHIP_0402
R32: 604kohm; passive-CHIP_0402
R37: 3.6kohm; passive-CHIP_0402
R38: 3.3kohm; passive-CHIP_0402
R40, R47, R48: 0ohm; passive-CHIP_0402
R43: 180kohm; passive-CHIP_0402
SW1, SW2, SW5, SW6: SKTDLDE010; openmicrodial_rev_a-FP_ALPS_SKTDLDE010
SW3, SW4: TactileSwitchSPST; switches-FP_CK_PTS636SM25
TP1, TP2, TP3, TP4, TP5, TP6, TP7, TP8, TP9, TP10: TestPoint; misc-FP_TEST_POINT_ROUND_1MM
U1: NS4150B; contrib_audio_amp-SOP8P65X490X110N
U2, U10: TPS22918; load_switch-FP_TI_DBV0006A
U3: H0216F002AM; openmicrodial_rev_a-FP_DIANWEI_8_03A5_031250
U4: W25Q128JV; soic-SOIC8P127X790X216N
U5: SF32LB525UC6; openmicrodial_rev_b-FP_SF32LB52X_QFN68L_BSide
U6: BQ24073RGTR; openmicrodial_rev_a-FP_TI_RGT_VQFN16_3x3_EP1p68
U7, U8: RT6150B; qfn-QFN10N50P250X250_1EP120X200
U20: USBLC6; esd-FP_SOT_23_6
Y1: Crystal_4pad; osc-FP_Crystal_SMD_2016_4Pin_E1SB

Connections:
ADC_REF: C13.1, U5.68
AMP_ENABLE: R3.1, U1.1, U5.50
AUDIO_REF: C15.1, U5.39
BT_RF: C52.1, C57.1, U5.53
BUCK_FB: C17.1, L3.2, U5.17
BUCK_LX: L3.1, U5.18
CAL: TP3.1, U5.51
CC1: J5.A5, R10.1
CC2: J5.B5, R11.1
CELL: C40.1, J3.1, TP2.1, U5.20, U6.2, U6.3
DAC_N: R2.1, U5.36
DAC_P: R1.1, U5.37
DEBUG_RX_SWDIO: TP6.1, U5.27
DEBUG_TX_SWCLK: TP8.1, U5.26
ENC_A: C38.1, R26.2, U5.61
ENC_B: C39.1, R27.2, U5.60
ENTER: C33.1, R21.2, U5.8
ESC: C34.1, R22.2, U5.7
FLASH_CLK: U4.6, U5.29
FLASH_CS: U4.1, U5.33
FLASH_IO0: U4.5, U5.30
FLASH_IO1: U4.2, U5.32
FLASH_IO2: U4.3, U5.31
FLASH_IO3: U4.7, U5.28
GND: C1.2, C5.2, C6.2, C7.2, C8.2, C9.2, C11.2, C12.2, C13.2, C14.2, C15.2, C16.2, C17.2, C18.2, C19.2, C20.2, C21.2, C22.2, C23.2, C24.2, C25.2, C26.2, C27.2, C28.2, C29.2, C30.2, C31.2, C32.2, C33.2, C34.2, C35.2, C36.2, C37.2, C38.2, C39.2, C40.2, C41.2, C42.2, C43.2, C44.2, C45.2, C46.2, C47.2, C48.2, C49.2, C50.2, C52.2, C53.2, C58.2, J2.1, J2.4, J3.3, J5.A1, J5.A12, J5.B1, J5.B12, J5.SH1, J5.SH2, J5.SH3, J5.SH4, L6.2, MK1.2, MK1.5, R3.2, R7.2, R9.2, R10.2, R11.2, R30.2, R31.2, R34.2, R36.2, R37.2, R38.2, R39.2, R43.2, R44.2, R45.2, SW1.1, SW2.1, SW3.2, SW4.2, SW5.1, SW6.1, TP4.1, U1.7, U2.2, U3.1, U3.7, U3.12, U3.22, U3.25, U3.28, U3.31, U3.MP, U4.4, U5.69, U6.4, U6.5, U6.8, U6.15, U6.17, U7.3, U7.7, U7.9, U7.11, U8.3, U8.7, U8.9, U8.11, U10.2, U20.2, Y1.2, Y1.4
I2C_SCL: R29.2, U3.5, U5.58
I2C_SDA: R28.2, U3.4, U5.59
IO_3V3: C5.1, C20.1, C43.1, C44.1, C49.1, R12.1, R13.1, R14.1, R15.1, R16.1, R17.1, R18.1, R19.1, R28.1, R29.1, R41.1, R42.1, R46.2, R48.1, TP10.1, U2.1, U3.8, U7.1, U10.1
MACRO_LEFT: C36.1, R24.2, U5.63
MACRO_RIGHT: C37.1, R25.2, U5.62
MCU_LDO1: C14.1, C22.1, C23.1, U4.8, U5.22, U5.38
MCU_LDO2: C24.1, U5.14
MCU_VSYS: C16.1, C31.1, U5.19, U5.52
MIC_PDM_CLK: R6.1, U5.11
MIC_PDM_DATA: MK1.4, R7.1, U5.10
MIC_POWER_ENABLE: R9.1, U2.3, U5.5
PANEL_4V: C18.1, C19.1, C46.1, C47.1, R32.1, U3.10, U8.1
PANEL_CLK: U3.18, U5.47
PANEL_CS: U3.15, U5.48
PANEL_D0: U3.16, U5.46
PANEL_D1: U3.17, U5.45
PANEL_D2: U3.20, U5.44
PANEL_D3: U3.19, U5.43
PANEL_ENABLE: R34.1, U5.35, U8.6
PANEL_LOGIC: C21.1, R35.1, U3.9, U3.11, U10.6
PANEL_RESET: R30.1, U3.14, U5.42
PANEL_TE: U3.21, U5.49
PANEL_VCI_ENABLE: R36.1, U5.34, U10.3
PTT: C32.1, R20.2, U5.9
RESET_ACTIVE_HIGH: R39.1, TP5.1, U5.66
RETENTION: C25.1, U5.13
RTC: C26.1, U5.12
SHIFT: C35.1, R23.2, U5.6
SIP_1V8: C27.1, U5.23
SYSTEM_SUPPLY: C11.1, C12.1, C28.1, C42.1, C45.1, C48.1, TP7.1, U1.6, U5.24, U6.6, U6.10, U6.11, U7.5, U7.6, U7.8, U8.5, U8.8
TOUCH_IRQ: R41.2, U3.2, U5.57
TOUCH_RESET: R45.1, U3.3, U5.56
TP_VCC: R48.2, U3.6
USB_C_N: J5.A7, J5.B7, U20.3
USB_C_P: J5.A6, J5.B6, U20.1
USB_MCU_N: U5.64, U20.4
USB_MCU_P: U5.65, U20.6
USB_VBUS: C41.1, J5.A4, J5.A9, J5.B4, J5.B9, TP9.1, U6.13, U20.5
VOUT1: C29.1, U5.16
VOUT2: C30.1, U5.15
XTAL48_XI: U5.55, Y1.1
XTAL48_XO: U5.54, Y1.3
audio::AC_N: C4.2, R5.1
audio::AC_P: C3.2, R4.1
audio::AMP_BYPASS: C1.1, U1.2
audio::AMP_INN: R5.2, U1.4
audio::AMP_INP: R4.2, U1.3
audio::AMP_VON: L2.1, U1.5
audio::AMP_VOP: L1.1, U1.8
audio::DAC_FILTER_N: C2.2, C4.1, R2.2
audio::DAC_FILTER_P: C2.1, C3.1, R1.2
audio::MIC_CLOCK: MK1.3, R6.2
audio::MIC_DISCHARGE: R8.1, U2.5
audio::MIC_SLEW: C6.1, U2.4
audio::MIC_SUPPLY: C7.1, MK1.1, R8.2, U2.6
audio::SPEAKER_MINUS: C9.1, C10.2, J1.2, L2.2
audio::SPEAKER_PLUS: C8.1, C10.1, J1.1, L1.2
controls::ENC_A_CONTACT: J2.2, R18.2, R26.1
controls::ENC_B_CONTACT: J2.3, R19.2, R27.1
controls::ENTER_CONTACT: R13.2, R21.1, SW1.2
controls::ESC_CONTACT: R14.2, R22.1, SW2.2
controls::MACRO_LEFT_CONTACT: R16.2, R24.1, SW3.1
controls::MACRO_RIGHT_CONTACT: R17.2, R25.1, SW4.1
controls::PTT_CONTACT: R12.2, R20.1, SW5.2
controls::SHIFT_CONTACT: R15.2, R23.1, SW6.2
power::CELL_TEMPERATURE: J3.2, R44.1, U6.1
power::CHG_ILIM: R38.1, U6.12
power::CHG_ISET: R37.1, U6.16
power::CHG_STATUS: R46.1, TP1.1, U5.67, U6.9
power::IO_FB: R42.2, R43.1, U7.10
power::IO_LX1: L4.1, U7.4
power::IO_LX2: L4.2, U7.2
power::PANEL_FB: R31.1, R32.2, U8.10
power::PANEL_LX1: L5.1, U8.4
power::PANEL_LX2: L5.2, U8.2
power::VCI_DISCHARGE: R35.2, U10.5
power::VCI_SLEW: C50.1, U10.4
rf::ANT_MATCH: L6.1, R40.2, R47.1
rf::BT_ANT: AE1.1, C58.1, R47.2
rf::BT_RF_LINE: C53.1, C57.2, R40.1
