ZhangHanDong/openwalkietalkie/hardware/rev-a/pcb-release-bodyv6.13-20260923-r6/encoder-wheel/encoder-wheel-45deg.kicad_pcb

## KiCad design hardware/rev-a/pcb-release-bodyv6.13-20260923-r6/encoder-wheel/encoder-wheel-45deg.kicad_pcb (2026-10-13, an earlier design)

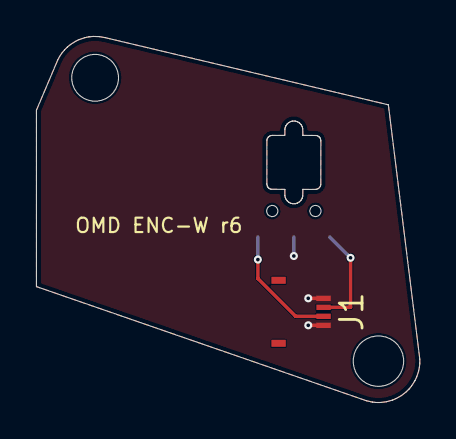
[picture p36: board encoder-wheel-45deg.kicad_pcb from above]

Board: 2 copper layers, 21.3 x 20.3 mm, 4 parts (1 on the bottom side), 3 nets.

Parts:
ENC1: EC05E1220401; openmicrodial_encoder_rev_a-FP_ALPS_EC05E1220401
J1: FH34SRJ-4S-0.5SH(99); openmicrodial_encoder_rev_a-FP_HIROSE_FH34SRJ_4S
MH1, MH2: Mounting hole

Connections:
ENC_A_CONTACT: ENC1.B, J1.2
ENC_B_CONTACT: ENC1.A, J1.3
GND: ENC1.C, J1.1, J1.4
