ZhangHanDong/openwalkietalkie/hardware/rev-b/jig/revb-flash-jig.kicad_pcb

## KiCad design hardware/rev-b/jig/revb-flash-jig.kicad_pcb (2026-10-13)

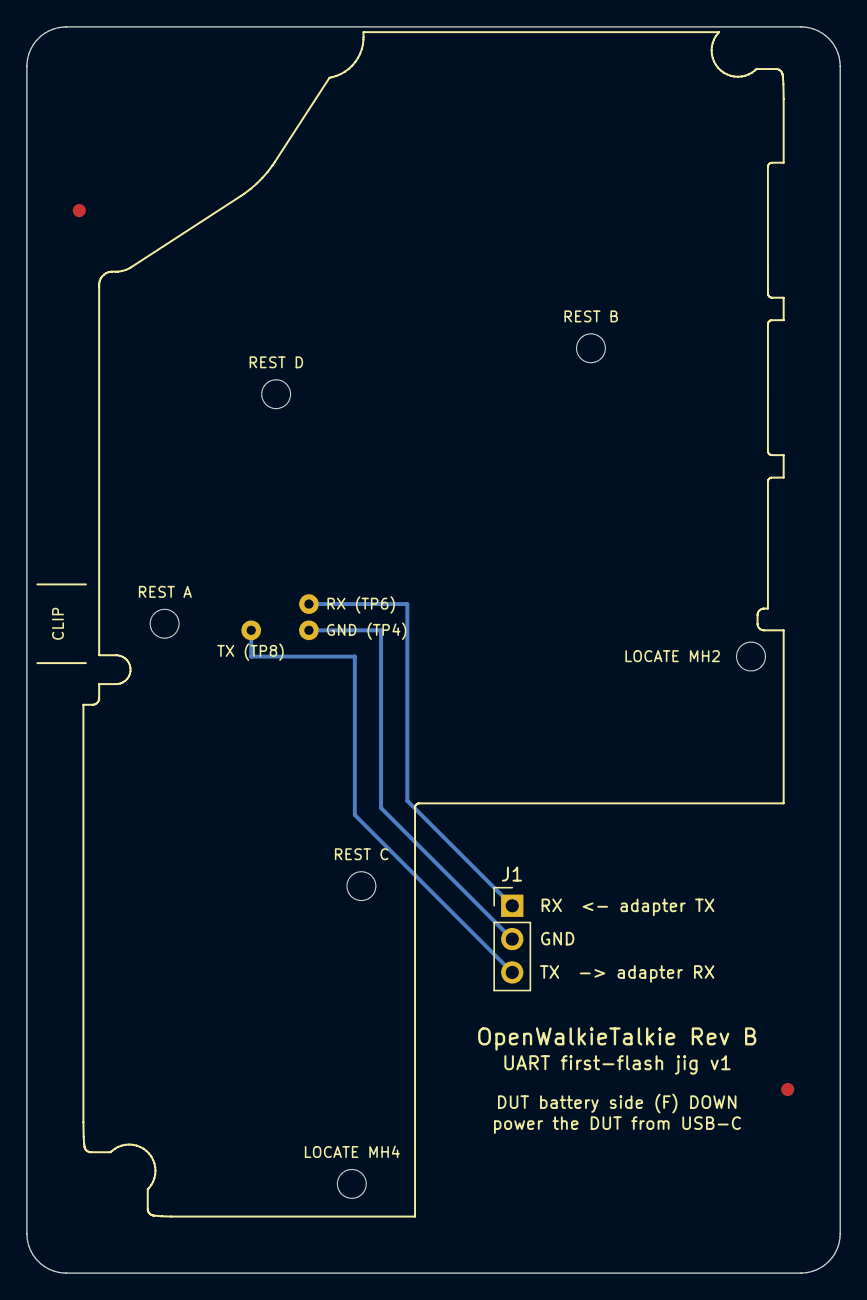
[picture p37: board revb-flash-jig.kicad_pcb from above]

Board: 2 copper layers, 62.0 x 95.0 mm, 12 parts (0 on the bottom side), 3 nets.

Parts:
FID1, FID2: Fiducial; Fiducial_1mm_Mask2mm
H1: LOCATE MH2; MountingHole_2.2mm_M2
H2: LOCATE MH4; MountingHole_2.2mm_M2
H3: REST A; MountingHole_2.2mm_M2
H4: REST B; MountingHole_2.2mm_M2
H5: REST D; MountingHole_2.2mm_M2
H6: REST C; MountingHole_2.2mm_M2
J1: UART; PinHeader_1x03_P2.54mm_Vertical
P1, P2, P3: YZ105312061P-01; Pogo_Xinyangze_YZ105312061P-01

Connections:
DUT_RX: J1.1, P1.1
DUT_TX: J1.3, P3.1
GND: J1.2, P2.1
