ZhangHanDong/openwalkietalkie/(commit log)

2026-10-13 Publish OpenWalkieTalkie website and document PID request
2026-10-14 Show device transcription hint for Claude without Channels
2026-10-14 Add device session model and thinking effort controls
2026-10-15 Display chat images in the Mac app and on the device
2026-10-15 Keep device image previews open across heartbeats and chat updates
2026-10-15 Set Rev B charging to 0.5C and add the Chinese assembly BOM
2026-10-16 Add device waitlist and website privacy notices
2026-10-16 Show Bluetooth signal strength on the device
2026-10-16 Update Rev B KiCad project state
2026-10-20 Separate factory packages by board with Chinese SPI NOR instructions
2026-10-21 Release 0.8.0 with screen lock and consistent wheel navigation
