ZhangHanDong/openwalkietalkie/(notices)

Notices in the files:
docs/host-service.md:
Icons are Solar Linear (480 Design, CC BY 4.0) plus a few drawn to match; Claude keeps its own orange.
